Postcard/figure-electronics/motherboard/kicad/Nomenclature-Mere_Figure-V2.xls

Sheet: Mere_Figure
 |  | Reference | Value | Footprint | Datasheet | Tension | ESR | Courant | Puissance | Tolerance | Fabricant | REF Fab | Distributeur | Ref Distri | Description
 |  |  |  |  |  | V | mOhms | A | W | %
Batterie
 | BT500 | BT501 | 3V-Lit | 20mm | http://www.farnell.com/datasheets/2082377.pdf | 3.3 |  |  |  |  | Panasonic | VL-2020/HFN | FARNELL | 8806551 (http://fr.farnell.com/panasonic-electronic-components/vl-2020-hfn/pile-rech-lithium-2020/dp/8806551) | Batterie rechargeable, Lithium-pentoxyde de vanadium, 20 mAh, 3 V, 2020, Broches CI, 20 mm
Condensateurs |  |  |  |  |  |  | 2
 | C200 | C201 | 22u | 2220 |  | 25 | 3 |  |  | 10 | KEMET | C2220X226K3RACAUTO | FARNELL | 2478282 (http://fr.farnell.com/kemet/c2220x226k3racauto/condensateur-mlcc-x7r-22uf-25v/dp/2478282) | Condensateur céramique multicouche CMS, 2220, 22 µF, 25 V, ± 10%, X7R
 |  | C202 | 22uF | 1206 |  | 16 |  |  |  | 20 | AVX | 1206YD226MAT2A | FARNELL | 1833823 (http://fr.farnell.com/avx/1206yd226mat2a/condensateur-mlcc-x5r-22uf-16v/dp/1833823) | Condensateur céramique multicouche CMS, 1206, 22 µF, 16 V, ± 20%, X5R
 |  | C203 | 15F | C pas 5,5 | http://www.farnell.com/datasheets/2259333.pdf | 2.7 | 35 |  |  |  | AVX | SCCT30B156SRB | FARNELL | 2696615 (http://fr.farnell.com/axiohm/scct30b156srb/super-condensateur-15f-2-7v-radial/dp/2696615) | Supercondensateur, 15 F, 2.7 V, SCC Series, +30%, -10%, À sorties radiales
 |  | C204 | 15F | C pas 5,5 | http://www.farnell.com/datasheets/2259333.pdf | 2.7 | 35 |  |  |  | AVX | SCCT30B156SRB | FARNELL | 2696615 (http://fr.farnell.com/axiohm/scct30b156srb/super-condensateur-15f-2-7v-radial/dp/2696615) | Supercondensateur, 15 F, 2.7 V, SCC Series, +30%, -10%, À sorties radiales
 |  | C205 | 15F | C pas 5,5 | http://www.farnell.com/datasheets/2259333.pdf | 2.7 | 35 |  |  |  | AVX | SCCT30B156SRB | FARNELL | 2696615 (http://fr.farnell.com/axiohm/scct30b156srb/super-condensateur-15f-2-7v-radial/dp/2696615) | Supercondensateur, 15 F, 2.7 V, SCC Series, +30%, -10%, À sorties radiales
 |  | C206 | 15F | C pas 5,5 | http://www.farnell.com/datasheets/2259333.pdf | 2.7 | 35 |  |  |  | AVX | SCCT30B156SRB | FARNELL | 2696615 (http://fr.farnell.com/axiohm/scct30b156srb/super-condensateur-15f-2-7v-radial/dp/2696615) | Supercondensateur, 15 F, 2.7 V, SCC Series, +30%, -10%, À sorties radiales
 |  | C207 | 22uF | 2220 |  | 25 | 3 |  |  | 10 | KEMET | C2220X226K3RACAUTO | FARNELL | 2478282 (http://fr.farnell.com/kemet/c2220x226k3racauto/condensateur-mlcc-x7r-22uf-25v/dp/2478282) | Condensateur céramique multicouche CMS, 2220, 22 µF, 25 V, ± 10%, X7R
 |  | C208 | 680p | 0603 |  | 100 |  |  |  |  | Multicomp | MC0603B681K101CT | FARNELL | 1759134 (http://fr.farnell.com/multicomp/mc0603b681k101ct/condensateur-mlcc-x7r-680pf-100v/dp/1759134) | Condensateur céramique multicouche CMS, 0603, 680 pF, 100 V, ± 10%, X7R, Série MC
 |  | C209 | 6p | 0603 |  | 25 |  |  |  |  | Multicomp | MC0603N6R0D500CT | FARNELL | 1759047 (http://fr.farnell.com/multicomp/mc0603n6r0d500ct/condensateur-mlcc-c0g-np0-6pf/dp/1759047) | Condensateur céramique multicouche CMS, 0603, 6 pF, 50 V, ± 0.5pF, C0G / NP0
 |  | C210 | 47uF | 1206 |  | 10 | 3 |  |  |  | KEMET | C1206C476M8PACTU | FARNELL | 1572639 (http://fr.farnell.com/kemet/c1206c476m8pactu/condensateur-mlcc-x5r-47uf-10v/dp/1572639) | Condensateur céramique multicouche CMS, 1206, 47 µF, 10 V, ± 20%, X5R, Série C
 |  | C211 | 10uF | 1206 |  | 16 |  |  |  | 10 | KEMET | C1206X106K4RACTU | FARNELL | 2575964 (http://fr.farnell.com/kemet/c1206x106k4ractu/condensateur-mlcc-x7r-10uf-16v/dp/2575964) | Condensateur céramique multicouche CMS, 1206 [3216 Metric], 10 µF, 16 V, ± 10%, X7R
 | C300 | C301 | 22u | 2220 |  | 25 | 3 |  |  | 10 | KEMET | C2220X226K3RACAUTO | FARNELL | 2478282 (http://fr.farnell.com/kemet/c2220x226k3racauto/condensateur-mlcc-x7r-22uf-25v/dp/2478282) | Condensateur céramique multicouche CMS, 2220, 22 µF, 25 V, ± 10%, X7R
 |  | C302 | 4u7 | 1210 |  | 25 |  |  |  | 10 | KEMET | C1210F475K3RACTU | FARNELL | 1358508 (http://fr.farnell.com/kemet/c1210f475k3ractu/condensateur-mlcc-x7r-4-7uf-25v/dp/1358508) | Condensateur céramique multicouche CMS, FO-CAP, 1210, 4.7 µF, 25 V, ± 10%, X7R
 |  | C303 | 43p | 0603 |  | 50 |  |  |  | 5 | KEMET | C0603C430J5GACTU | FARNELL | 1865479 (http://fr.farnell.com/kemet/c0603c430j5gactu/condensateur-mlcc-c0g-np0-43pf/dp/1865479) | Condensateur céramique multicouche CMS, 0603, 43 pF, 50 V, ± 5%, C0G / NP0, Série C
 |  | C304 | 9n1 | 0603 |  | 50 |  |  |  | 5 | KEMET | C0603X912J5JACTU | FARNELL | 2579122 (http://fr.farnell.com/kemet/c0603x912j5jactu/condo-mlcc-u2j-9100pf-50v-0603/dp/2579122) | Condensateur céramique multicouche CMS, 0603, 9100 pF, 50 V, ± 5%, U2J
 |  | C305 | 100n | 0603 |  | 25 |  |  |  | 10 | Multicomp | MC0603B104K250CT | FARNELL | 1759037 (http://fr.farnell.com/multicomp/mc0603b104k250ct/condensateur-mlcc-x7r-100nf-25v/dp/1759037) | Condensateur céramique multicouche CMS, 0603, 0.1 µF, 25 V, ± 10%, X7R, Série MC
 |  | C306 | 51p | 0603 |  | 50 |  |  |  | 5 | KEMET | C0603C510J5GACTU | FARNELL | 1865480 (http://fr.farnell.com/kemet/c0603c510j5gactu/condensateur-mlcc-c0g-np0-51pf/dp/1865480) | Condensateur céramique multicouche CMS, 0603, 51 pF, 50 V, ± 5%, C0G / NP0, Série C
 |  | C307 | 2n7 | 0603 |  | 50 |  |  |  | 10 | Multicomp | MC0603B272K500CT | FARNELL | 1759094 (http://fr.farnell.com/multicomp/mc0603b272k500ct/condensateur-mlcc-x7r-2-7nf-50v/dp/1759094) | Condensateur céramique multicouche CMS, 0603, 2700 pF, 50 V, ± 10%, X7R, Série MC
 |  | C308 | 22p | 0603 |  | 50 |  |  |  | 10 | Multicomp | MCU0603C220JCT | FARNELL | 9406107 (http://fr.farnell.com/multicomp/mcu0603c220jct/condensateur-mlcc-c0g-np0-22pf/dp/9406107) | Condensateur céramique multicouche CMS, 0603, 22 pF, 50 V, ± 5%, C0G / NP0, Série MCU
 |  | C309 | 22u | 1206 |  | 16 |  |  |  | 20 | AVX | 1206YD226MAT2A | FARNELL | 1833823 (http://fr.farnell.com/avx/1206yd226mat2a/condensateur-mlcc-x5r-22uf-16v/dp/1833823) | Condensateur céramique multicouche CMS, 1206, 22 µF, 16 V, ± 20%, X5R
 | C400 | C401 | 22u | 2220 |  | 25 | 3 |  |  | 10 | KEMET | C2220X226K3RACAUTO | FARNELL | 2478282 (http://fr.farnell.com/kemet/c2220x226k3racauto/condensateur-mlcc-x7r-22uf-25v/dp/2478282) | Condensateur céramique multicouche CMS, 2220, 22 µF, 25 V, ± 10%, X7R
 |  | C402 | 100n | 0603 |  | 25 |  |  |  | 10 | Multicomp | MC0603B104K250CT | FARNELL | 1759037 (http://fr.farnell.com/multicomp/mc0603b104k250ct/condensateur-mlcc-x7r-100nf-25v/dp/1759037) | Condensateur céramique multicouche CMS, 0603, 0.1 µF, 25 V, ± 10%, X7R, Série MC
 |  | C403 | 1n5 | 0603 |  | 50 |  |  |  | 10 | Multicomp | MC0603B152K500CT | FARNELL | 1759091 (http://fr.farnell.com/multicomp/mc0603b152k500ct/condensateur-mlcc-x7r-1-5nf-50v/dp/1759091) | Condensateur céramique multicouche CMS, 0603, 1500 pF, 50 V, ± 10%, X7R, Série MC
 |  | C404 | 27n | 0603 |  | 50 |  |  |  | 10 | Multicomp | MC0603B273K500CT | FARNELL | 1759111 (http://fr.farnell.com/multicomp/mc0603b273k500ct/condensateur-mlcc-x7r-27nf-50v/dp/1759111) | Condensateur céramique multicouche CMS, 0603 [1608 Metric], 0.027 µF, 50 V, ± 10%, X7R, Série MC
 |  | C405 | 10n | 0603 |  | 50 |  |  |  | 10 | Multicomp | MC0603B103K500CT | FARNELL | 1759102 (http://fr.farnell.com/multicomp/mc0603b103k500ct/condensateur-mlcc-x7r-10nf-50v/dp/1759102) | Condensateur céramique multicouche CMS, 0603, 0.01 µF, 50 V, ± 10%, X7R, Série MC
 |  | C406 | 82u | E12 |  | 35 | 20 |  |  | 10 | Panasonic | 35SVPF82M | FARNELL | 2354811 (http://fr.farnell.com/panasonic-electronic-components/35svpf82m/condensateur-elec-alu-82uf-35v/dp/2354811) | CONDENSATEUR ELEC ALU 82UF 35V CMS
 |  | C407 | 82u | E12 |  | 35 | 20 |  |  | 10 | Panasonic | 35SVPF82M | FARNELL | 2354811 (http://fr.farnell.com/panasonic-electronic-components/35svpf82m/condensateur-elec-alu-82uf-35v/dp/2354811) | CONDENSATEUR ELEC ALU 82UF 35V CMS
 |  | C408 | 100n | 0603 |  | 25 |  |  |  | 10 | Multicomp | MC0603B104K250CT | FARNELL | 1759037 (http://fr.farnell.com/multicomp/mc0603b104k250ct/condensateur-mlcc-x7r-100nf-25v/dp/1759037) | Condensateur céramique multicouche CMS, 0603, 0.1 µF, 25 V, ± 10%, X7R, Série MC
 | C500 | C501 | 1u | 0603 |  | 10 |  |  |  | 10 | Multicomp | MC0603X105K100CT | FARNELL | 1759399 (http://fr.farnell.com/multicomp/mc0603x105k100ct/condensateur-mlcc-x5r-1uf-10v/dp/1759399) | Condensateur céramique multicouche CMS, 0603, 1 µF, 10 V, ± 10%, X5R, Série MC
 |  | C502 | 6p | 0603 |  | 50 |  |  |  | 10 | Multicomp | MC0603N6R0D500CT | FARNELL | 1759047 (http://fr.farnell.com/multicomp/mc0603n6r0d500ct/condensateur-mlcc-c0g-np0-6pf/dp/1759047) | Condensateur céramique multicouche CMS, 0603, 6 pF, 50 V, ± 0.5pF, C0G / NP0
 |  | C503 | 6p | 0603 |  | 50 |  |  |  | 10 | Multicomp | MC0603N6R0D500CT | FARNELL | 1759047 (http://fr.farnell.com/multicomp/mc0603n6r0d500ct/condensateur-mlcc-c0g-np0-6pf/dp/1759047) | Condensateur céramique multicouche CMS, 0603, 6 pF, 50 V, ± 0.5pF, C0G / NP0
 |  | C504 | 1u | 0603 |  | 10 |  |  |  | 10 | Multicomp | MC0603X105K100CT | FARNELL | 1759399 (http://fr.farnell.com/multicomp/mc0603x105k100ct/condensateur-mlcc-x5r-1uf-10v/dp/1759399) | Condensateur céramique multicouche CMS, 0603, 1 µF, 10 V, ± 10%, X5R, Série MC
 | C600 | C601 | 22u | 2220 |  | 25 | 3 |  |  | 10 | KEMET | C2220X226K3RACAUTO | FARNELL | 2478282 (http://fr.farnell.com/kemet/c2220x226k3racauto/condensateur-mlcc-x7r-22uf-25v/dp/2478282) | Condensateur céramique multicouche CMS, 2220, 22 µF, 25 V, ± 10%, X7R
 |  | C602 | 4u7 | 1210 |  | 25 |  |  |  | 10 | KEMET | C1210F475K3RACTU | FARNELL | 1358508 (http://fr.farnell.com/kemet/c1210f475k3ractu/condensateur-mlcc-x7r-4-7uf-25v/dp/1358508) | Condensateur céramique multicouche CMS, FO-CAP, 1210, 4.7 µF, 25 V, ± 10%, X7R
 |  | C603 | 43p | 0603 |  | 50 |  |  |  | 5 | KEMET | C0603C430J5GACTU | FARNELL | 1865479 (http://fr.farnell.com/kemet/c0603c430j5gactu/condensateur-mlcc-c0g-np0-43pf/dp/1865479) | Condensateur céramique multicouche CMS, 0603, 43 pF, 50 V, ± 5%, C0G / NP0, Série C
 |  | C604 | 56n | 0603 |  | 16 |  |  |  | 10 | Multicomp | MC0603B563K160CT | FARNELL | 1759013 (http://fr.farnell.com/multicomp/mc0603b563k160ct/condensateur-mlcc-x7r-56nf-16v/dp/1759013) | Condensateur céramique multicouche CMS, 0603, 0.056 µF, 16 V, ± 10%, X7R, Série MC
 |  | C605 | 100n | 0603 |  | 25 |  |  |  | 10 | Multicomp | MC0603B104K250CT | FARNELL | 1759037 (http://fr.farnell.com/multicomp/mc0603b104k250ct/condensateur-mlcc-x7r-100nf-25v/dp/1759037) | Condensateur céramique multicouche CMS, 0603, 0.1 µF, 25 V, ± 10%, X7R, Série MC
 |  | C606 | 110p | 0402 |  | 50 |  |  |  | 5 | Multicomp | MC0402N111J500CT | FARNELL | 1758970 (http://fr.farnell.com/multicomp/mc0402n111j500ct/condensateur-mlcc-c0g-np0-110pf/dp/1758970) | Condensateur céramique multicouche CMS, 0402, 110 pF, 50 V, ± 5%, C0G / NP0, Série MC
 |  | C607 | 2n7 | 0603 |  | 50 |  |  |  | 10 | Multicomp | MC0603B272K500CT | FARNELL | 1759094 (http://fr.farnell.com/multicomp/mc0603b272k500ct/condensateur-mlcc-x7r-2-7nf-50v/dp/1759094) | Condensateur céramique multicouche CMS, 0603, 2700 pF, 50 V, ± 10%, X7R, Série MC
 |  | C608 | 22p | 0603 |  | 50 |  |  |  | 10 | Multicomp | MCU0603C220JCT | FARNELL | 9406107 (http://fr.farnell.com/multicomp/mcu0603c220jct/condensateur-mlcc-c0g-np0-22pf/dp/9406107) | Condensateur céramique multicouche CMS, 0603, 22 pF, 50 V, ± 5%, C0G / NP0, Série MCU
 |  | C609 | 22u | 1206 |  | 16 |  |  |  | 20 | AVX | 1206YD226MAT2A | FARNELL | 1833823 (http://fr.farnell.com/avx/1206yd226mat2a/condensateur-mlcc-x5r-22uf-16v/dp/1833823) | Condensateur céramique multicouche CMS, 1206, 22 µF, 16 V, ± 20%, X5R
 | C700 | C701 | 10u | 1206 |  | 25 |  |  |  | 10 | Multicomp | MC1206X106K250CT | FARNELL | 2320887 (http://fr.farnell.com/multicomp/mc1206x106k250ct/condensateur-mlcc-x5r-10uf-25v/dp/2320887) | Condensateur céramique multicouche CMS, 1206 , 10 µF, 25 V, ± 10%, X5R, Série MC
 |  | C702 | 10u | 1206 |  | 25 |  |  |  | 10 | Multicomp | MC1206X106K250CT | FARNELL | 2320887 (http://fr.farnell.com/multicomp/mc1206x106k250ct/condensateur-mlcc-x5r-10uf-25v/dp/2320887) | Condensateur céramique multicouche CMS, 1206 , 10 µF, 25 V, ± 10%, X5R, Série MC
 | C800 | C801 | 33n | 15mm |  | 310 |  |  | X2-300 | 10 | Wurth | 890334025006CS | FARNELL | 2449960 (http://fr.farnell.com/wurth-elektronik/890334025006cs/condensateur-film-pp-0-033uf-310vac/dp/2449960) | Condensateur film, 0.033 µF, 310 V, Polypropylène (PP), ± 10%, Série WCAP-FTXX
 |  | C802 | 100n | 22,5mm |  | 300 |  |  |  | 20 | KEMET | R413N310040M1M | FARNELL | 2495804 (http://fr.farnell.com/kemet/r413n310040m1m/condens-sup-y2-pp-0-1uf-300vac/dp/2495804) | Condensateur film, 0.1 µF, Y2, 300 V, ± 20%, Série R41, À sorties radiales
 |  | C803 | 10u | 1206 |  | 16 |  |  |  | 10 | KEMET | C1206X106K4RACTU | FARNELL | 2575964 (http://fr.farnell.com/kemet/c1206x106k4ractu/condensateur-mlcc-x7r-10uf-16v/dp/2575964) | Condensateur céramique multicouche CMS, 1206 [3216 Metric], 10 µF, 16 V, ± 10%, X7R
Diodes
 | D100 | D101 | SBR2A40 | PowerDI123 | http://www.farnell.com/datasheets/2096657.pdf | 40 |  | 2 |  |  | Diodes Inc | SBR2A40P1-7 | FARNELL | 1713961 (http://fr.farnell.com/diodes-inc/sbr2a40p1-7/redresseur-super-b-powerdi-123/dp/1713961) | Diode de récupération standard, POWERDI®, 40 V, 2 A, Une, 500 mV, 50 A
 | D200 | D201 | SBR2A40 | PowerDI123 | http://www.farnell.com/datasheets/2096657.pdf | 40 |  | 2 |  |  | Diodes Inc | SBR2A40P1-7 | FARNELL | 1713961 (http://fr.farnell.com/diodes-inc/sbr2a40p1-7/redresseur-super-b-powerdi-123/dp/1713961) | Diode de récupération standard, POWERDI®, 40 V, 2 A, Une, 500 mV, 50 A
 |  | D202 | SBR2A40 | PowerDI123 | http://www.farnell.com/datasheets/2096657.pdf | 40 |  | 2 |  |  | Diodes Inc | SBR2A40P1-7 | FARNELL | 1713961 (http://fr.farnell.com/diodes-inc/sbr2a40p1-7/redresseur-super-b-powerdi-123/dp/1713961) | Diode de récupération standard, POWERDI®, 40 V, 2 A, Une, 500 mV, 50 A
 |  | D203 | SBR2A40 | PowerDI123 | http://www.farnell.com/datasheets/2096657.pdf | 40 |  | 2 |  |  | Diodes Inc | SBR2A40P1-7 | FARNELL | 1713961 (http://fr.farnell.com/diodes-inc/sbr2a40p1-7/redresseur-super-b-powerdi-123/dp/1713961) | Diode de récupération standard, POWERDI®, 40 V, 2 A, Une, 500 mV, 50 A
 |  | D204 | SBR2A40 | PowerDI123 | http://www.farnell.com/datasheets/2096657.pdf | 40 |  | 2 |  |  | Diodes Inc | SBR2A40P1-7 | FARNELL | 1713961 (http://fr.farnell.com/diodes-inc/sbr2a40p1-7/redresseur-super-b-powerdi-123/dp/1713961) | Diode de récupération standard, POWERDI®, 40 V, 2 A, Une, 500 mV, 50 A
 | D400 | D401 | MBRD835LT4G | TO-252 | http://www.farnell.com/datasheets/33914.pdf | 35 |  | 8 |  |  | ON Semi | MBRD835LT4G | FARNELL | 1611349 (http://fr.farnell.com/on-semiconductor/mbrd835lt4g/diode-schottky/dp/1611349) | Redresseur Schottky, 35 V, 8 A, Une, TO-252, 3 Broche(s), 510 mV
 | D500 | D501 | Zener-3V3 | SOD-323FL | http://www.farnell.com/datasheets/2021487.pdf | 3.3 |  |  |  |  | Rohm | UDZVFHTE-173.3B | FARNELL | 2528863 (http://fr.farnell.com/rohm/udzvfhte-173-3b/diode-zener-3-3v-sod-323fl/dp/2528863) | Diode simple Zener, AEC-Q101, 3.3 V, 200 mW, SOD-323FL, 2 Broche(s), 150 °C
 | D700 | D701 | SBR2A40 | PowerDI123 | http://www.farnell.com/datasheets/2096657.pdf | 40 |  | 2 |  |  | Diodes Inc | SBR2A40P1-7 | FARNELL | 1713961 (http://fr.farnell.com/diodes-inc/sbr2a40p1-7/redresseur-super-b-powerdi-123/dp/1713961) | Diode de récupération standard, POWERDI®, 40 V, 2 A, Une, 500 mV, 50 A
 |  | D702 | SBR2A40 | PowerDI123 | http://www.farnell.com/datasheets/2096657.pdf | 40 |  | 2 |  |  | Diodes Inc | SBR2A40P1-7 | FARNELL | 1713961 (http://fr.farnell.com/diodes-inc/sbr2a40p1-7/redresseur-super-b-powerdi-123/dp/1713961) | Diode de récupération standard, POWERDI®, 40 V, 2 A, Une, 500 mV, 50 A
 | D800 | D801 | 1N4001 | DO41 | http://www.farnell.com/datasheets/639187.pdf |  |  |  |  |  | Diodes Inc | 1N4001-T | FARNELL | 1843694 (http://fr.farnell.com/diodes-inc/1n4001-t/diode-de-redressement-50v1ado/dp/1843694) | Diode de récupération standard, 50 V, 1 A, Une, 1 V, 30 A
Inductances
 | L300 | L301 | 3u3 | WE-HCI | http://www.farnell.com/datasheets/1735740.pdf |  | 17.2 | 6.5 |  |  | WURTH | 744311330 | FARNELL | 1636193 (http://fr.farnell.com/wurth-elektronik/744311330/inductance-fort-courant-2/dp/1636193) | Inductance de puissance CMS, Série WE-HCI, 3.3 µH, 6.5 A, 11 A, Blindé, 0.0172 ohm
 | L400 | L401 | 10u | WE-HCC | http://www.farnell.com/datasheets/654696.pdf |  | 14.4 | 9 |  |  | WURTH | 744332100 | FARNELL | 1848238 (http://fr.farnell.com/wurth-elektronik/7443321000/inductor-10uh-9a-20/dp/1848238) | Inductance de puissance CMS, Série WE-HCC, 10 µH, 9 A, 10 A, Blindé, 0.0144 ohm
 | L600 | L601 | 10u | VLP | http://www.farnell.com/datasheets/2124514.pdf |  | 40 | 3.5 |  |  | TDK | VLP8040T-100M | FARNELL | 2345211 (http://fr.farnell.com/tdk/vlp8040t-100m/inductance-puissance-10uh-3-2a/dp/2345211) | Inductance de puissance CMS, Série VLP, 10 µH, 3.5 A, 3.2 A, Blindé, 0.038 ohm
Connecteurs
 | P100 | P101 | Master-12V | 5mm | http://docs-europe.electrocomponents.com/webdocs/14fb/0900766b814fb452.pdf | 12 |  | 16 |  |  | WURTH | 691386700002 | RS | 122-4903 (http://fr.rs-online.com/web/p/borniers-pour-ci/1224903/?searchTerm=122-4903) | Bloc de jonction enfichable Embase CI, Wurth Elektronik, série 3867, pas 5mm, 2 Contacts, A souder
 |  | P102 | detection-230V | 7,62mm | http://docs-europe.electrocomponents.com/webdocs/133a/0900766b8133a1eb.pdf | 230 |  | 20 |  |  | WURTH | 691313410003 | RS | 826-7481 (http://fr.rs-online.com/web/p/borniers-pour-ci/8267481/?searchTerm=826-7481) | Bloc de jonction enfichable Embase CI, Wurth Elektronik, série 3134, pas 7.62mm, 3 Contacts, Angle droit
 |  | P103 | Secteur | 7,62mm | http://docs-europe.electrocomponents.com/webdocs/133a/0900766b8133a1eb.pdf | 230 |  | 20 |  |  | WURTH | 691313410003 | RS | 826-7481 (http://fr.rs-online.com/web/p/borniers-pour-ci/8267481/?searchTerm=826-7481) | Bloc de jonction enfichable Embase CI, Wurth Elektronik, série 3134, pas 7.62mm, 3 Contacts, Angle droit
 |  | P104 | Secteur | 7,62mm | http://docs-europe.electrocomponents.com/webdocs/133a/0900766b8133a1eb.pdf | 230 |  | 20 |  |  | WURTH | 691313410003 | RS | 826-7481 (http://fr.rs-online.com/web/p/borniers-pour-ci/8267481/?searchTerm=826-7481) | Bloc de jonction enfichable Embase CI, Wurth Elektronik, série 3134, pas 7.62mm, 3 Contacts, Angle droit
 |  | P105 | 2Pts-CANON 1200D | 3,81mm | http://docs-europe.electrocomponents.com/webdocs/133a/0900766b8133a1f8.pdf | 7.4 |  | 10.5 |  |  | WURTH | 691322310004 | RS | 824-6655 (http://fr.rs-online.com/web/p/borniers-pour-ci/8246655/?searchTerm=824-6655) | Bloc de jonction enfichable Embase CI, Wurth Elektronik, série 322, pas 3.81mm, 4 Contacts, Droit, montage Traversant
 |  | P106 | 2Pts-Flash | 3,81mm | http://docs-europe.electrocomponents.com/webdocs/133a/0900766b8133a1f8.pdf | 6.5 |  | 10.5 |  |  | WURTH | 691322310002 | RS | 824-6658 (http://fr.rs-online.com/web/p/borniers-pour-ci/8246658/?searchTerm=824-6658) | Bloc de jonction enfichable Embase CI, Wurth Elektronik, série 322, pas 3.81mm, 2 Contacts, Droit, montage Traversant
 |  | P107 | 2Pts-shutter |  |  |  |  |  |  |  |  | voir P105
 |  | P108 | Bouton Poussoir | 2,5mm | http://docs-europe.electrocomponents.com/webdocs/14fb/0900766b814fb43a.pdf | 5 |  | 12 |  |  | WURTH | 691382010002 | RS | 122-4921 (http://fr.rs-online.com/web/p/borniers-pour-ci/1224921/?searchTerm=122-4921) | Bloc de jonction enfichable Embase CI, Wurth Elektronik, série 382, pas 2.5mm, 2 Contacts, Horizontal, A souder
 |  | P109 | HT910-E | 6P6C | http://docs-europe.electrocomponents.com/webdocs/1388/0900766b81388626.pdf | 12 |  | 1 |  |  | MOLEX | 95522-2667 | RS | 848-6705 (http://fr.rs-online.com/web/p/connecteurs-rj11/8486705/?searchTerm=848-6705) | Embase Modulaire, Femelle, 6P6C, Non blindé, Droit, Traversant,
 |  | P110 | GACHE | 3,5mm | http://docs-europe.electrocomponents.com/webdocs/133a/0900766b8133a1f7.pdf | 12 |  | 10.5 |  |  | WURTH | 691322110002 | RS | 824-6636 (http://fr.rs-online.com/web/p/borniers-pour-ci/8246636/?searchTerm=824-6636) | Bloc de jonction enfichable Embase CI, Wurth Elektronik, série 3221, pas 3.5mm, 2 Contacts, Droit, montage Traversant
 |  | P111 | 24V-PRINT | 3,5mm | http://docs-europe.electrocomponents.com/webdocs/133a/0900766b8133a1f7.pdf | 24 |  | 10.5 |  |  | WURTH | 691322110002 | RS | 824-6636 (http://fr.rs-online.com/web/p/borniers-pour-ci/8246636/?searchTerm=824-6636) | Bloc de jonction enfichable Embase CI, Wurth Elektronik, série 3221, pas 3.5mm, 2 Contacts, Droit, montage Traversant
 | P500 | P501 | alim | 5mm | http://docs-europe.electrocomponents.com/webdocs/133a/0900766b8133a1d7.pdf | 5 |  |  |  |  | WURTH | 691101710002 | RS | 826-7214 (http://fr.rs-online.com/web/p/borniers-pour-ci/8267214/?searchTerm=826-7214) | Bornier pour CI Bloc de jonction PCB, Wurth Elektronik, série 101, pas 5mm, 2 Contacts, Droit, montage Traversant
Transistors
 | Q100 | Q101 | Q_NMOS_GSD | TO-252 | http://www.farnell.com/datasheets/2050341.pdf | 100 | 0.162 | 8.8 |  |  | VISHAY | SUD09P10-195-GE3 | FARNELL | 1859014 (http://fr.farnell.com/vishay/sud09p10-195-ge3/mosfet-canal-p-diode-100v-8-8a/dp/1859014) | Transistor MOSFET, Canal P, -8.8 A, -100 V, 0.162 ohm, -10 V, -1 V
 | Q300 | Q301 | Q_NMOS_GSD | SOT-23 | http://www.farnell.com/datasheets/2246751.pdf | 100 | 1200 | 0.17 |  |  | Fairchild | BSS123 | FARNELL | 2251951 (http://fr.farnell.com/fairchild-semiconductor/bss123/mosfet-n-ch-100v-170ma-sot-23/dp/2251951) | Transistor MOSFET, Canal N, 170 mA, 100 V, 1.2 ohm, 10 V, 1.7 V
 | Q400 | Q401 | CSD17304Q3 | Q3 Pack | http://www.ti.com/lit/ds/symlink/csd17304q3.pdf | 30 | 6 | 56 |  |  | Texas | CSD17304Q3 | FARNELL | 2501089 (http://fr.farnell.com/texas-instruments/csd17304q3/mosfet-canal-n-30v-56a-vson-8/dp/2501089) | Transistor MOSFET, Canal N, 56 A, 30 V, 0.0059 ohm, 8 V, 1.3 V
 | Q500 | Q501 | Q_NMOS_GSD | SOT-23 | http://www.farnell.com/datasheets/2246751.pdf | 100 | 1200 | 0.17 |  |  | Fairchild | BSS123 | FARNELL | 2251951 (http://fr.farnell.com/fairchild-semiconductor/bss123/mosfet-n-ch-100v-170ma-sot-23/dp/2251951) | Transistor MOSFET, Canal N, 170 mA, 100 V, 1.2 ohm, 10 V, 1.7 V
 | Q700 | Q701 | Q_NMOS_GSD | SOT-23 | http://www.farnell.com/datasheets/2246751.pdf | 100 | 1200 | 0.17 |  |  | Fairchild | BSS123 | FARNELL | 2251951 (http://fr.farnell.com/fairchild-semiconductor/bss123/mosfet-n-ch-100v-170ma-sot-23/dp/2251951) | Transistor MOSFET, Canal N, 170 mA, 100 V, 1.2 ohm, 10 V, 1.7 V
 |  | Q702 | Q_NMOS_GSD | SOT-23 | http://www.farnell.com/datasheets/2246751.pdf | 100 | 1200 | 0.17 |  |  | Fairchild | BSS123 | FARNELL | 2251951 (http://fr.farnell.com/fairchild-semiconductor/bss123/mosfet-n-ch-100v-170ma-sot-23/dp/2251951) | Transistor MOSFET, Canal N, 170 mA, 100 V, 1.2 ohm, 10 V, 1.7 V
Resistances
 | R100 | R101 | 1Meg | 0603 |  | 50 |  |  | 0.1 | 1 | YAGEO | RC0603FR-071ML | FARNELL | 9238840 (http://fr.farnell.com/yageo-phycomp/rc0603fr-071ml/res-couche-epaisse-1m-1-0-1w-0603/dp/9238840) | Résistance à puce CMS, Couche épaisse, 1 Mohm, 50 V, 0603, 100 mW, ± 1%, Série RC
 | R200 | R202 | 0 | 0603 |  | 50 |  |  | 0.1 | 1 | YAGEO | RC0603FR-070RL | FARNELL | 2309106 (http://fr.farnell.com/yageo/rc0603fr-070rl/res-couche-epaisse-0r-1-0-1w-0603/dp/2309106) | Résistance à puce CMS, Couche épaisse, 0 ohm, 50 V,0603, 100 mW, ± 1%, Série RC
 |  | R201 | 0 | 0603 |  | 50 |  |  | 0.1 | 1 | YAGEO | RC0603FR-070RL | FARNELL | 2309106 (http://fr.farnell.com/yageo/rc0603fr-070rl/res-couche-epaisse-0r-1-0-1w-0603/dp/2309106) | Résistance à puce CMS, Couche épaisse, 0 ohm, 50 V, 0603, 100 mW, ± 1%, Série RC
 |  | R203 | 240 | 0603 |  | 75 |  |  | 0.1 | 1 | WALSIN | WR06X2400FTL | FARNELL | 2670708 (http://fr.farnell.com/walsin/wr06x2400ftl/res-couche-epaisse-240r-1-0-1w/dp/2670708) | Résistance à puce CMS, 240 ohm, 75 V, 0603, 100 mW, ± 1%, WR06 Series
 |  | R204 | 1650 | 0603 |  | 75 |  |  | 0.1 | 1 | WALSIN | WR06X1651FTL | FARNELL | 2670655 (http://fr.farnell.com/walsin/wr06x1651ftl/res-couche-epaisse-1k65-1-0-1w/dp/2670655) | Résistance à puce CMS, 1.65 kohm, 75 V, 0603, 100 mW, ± 1%, WR06 Series
 |  | R205 | 10k | 0603 |  | 75 |  |  | 0.1 | 1 | VISHAY | CRCW060310K0JNEA | FARNELL | 2693095 (http://fr.farnell.com/vishay/crcw060310k0jnea/res-aec-q200-10k-5-0-1w-0603/dp/2693095) | Résistance à puce CMS, 10 kohm, 75 V, 0603, 100 mW, ± 5%, CRCW Series
 |  | R206 | 10k | 0603 |  | 75 |  |  | 0.1 | 1 | VISHAY | CRCW060310K0JNEA | FARNELL | 2693095 (http://fr.farnell.com/vishay/crcw060310k0jnea/res-aec-q200-10k-5-0-1w-0603/dp/2693095) | Résistance à puce CMS, 10 kohm, 75 V, 0603, 100 mW, ± 5%, CRCW Series
 |  | R207 | 10k | 0603 |  | 75 |  |  | 0.1 | 1 | VISHAY | CRCW060310K0JNEA | FARNELL | 2693095 (http://fr.farnell.com/vishay/crcw060310k0jnea/res-aec-q200-10k-5-0-1w-0603/dp/2693095) | Résistance à puce CMS, 10 kohm, 75 V, 0603, 100 mW, ± 5%, CRCW Series
 |  | R208 | 10k | 0603 |  | 75 |  |  | 0.1 | 1 | VISHAY | CRCW060310K0JNEA | FARNELL | 2693095 (http://fr.farnell.com/vishay/crcw060310k0jnea/res-aec-q200-10k-5-0-1w-0603/dp/2693095) | Résistance à puce CMS, 10 kohm, 75 V, 0603, 100 mW, ± 5%, CRCW Series
 |  | R209 | 100k | 0603 |  | 50 |  |  | 0.1 | 1 | YAGEO | RC0603FR-07100KL | FARNELL | 9238727 (http://fr.farnell.com/yageo-phycomp/rc0603fr-07100kl/res-couche-epaisse-100k-1-0-1w/dp/9238727) | Résistance à puce CMS, Couche épaisse, 100 kohm, 50 V, 0603, 100 mW, ± 1%, Série RC
 |  | R210 | 523k | 0603 |  | 75 |  |  | 0.1 | 1 | WALSIN | WR06X5233FTL | FARNELL | 2670836 (http://fr.farnell.com/walsin/wr06x5233ftl/res-couche-epaisse-523k-1-0-1w/dp/2670836) | Résistance à puce CMS, 523 kohm, 75 V, 0603, 100 mW, ± 1%, WR06 Series
 |  | R211 | 100k | 0603 |  | 50 |  |  | 0.1 | 1 | YAGEO | RC0603FR-07100KL | FARNELL | 9238727 (http://fr.farnell.com/yageo-phycomp/rc0603fr-07100kl/res-couche-epaisse-100k-1-0-1w/dp/9238727) | Résistance à puce CMS, Couche épaisse, 100 kohm, 50 V, 0603, 100 mW, ± 1%, Série RC
 | R300 | R301 | 0 | 0603 |  | 50 |  |  | 0.1 | 1 | YAGEO | RC0603FR-070RL | FARNELL | 2309106 (http://fr.farnell.com/yageo/rc0603fr-070rl/res-couche-epaisse-0r-1-0-1w-0603/dp/2309106) | Résistance à puce CMS, Couche épaisse, 0 ohm, 50 V, 0603, 100 mW, ± 1%, Série RC
 |  | R302 | 105k | 0603 |  | 75 |  |  | 0.1 | 1 | WALSIN | WR06X1053FTL | FARNELL | 2670599 (http://fr.farnell.com/walsin/wr06x1053ftl/res-couche-epaisse-105k-1-0-1w/dp/2670599) | Résistance à puce CMS, 105 kohm, 75 V, 0603, 100 mW, ± 1%, WR06 Series
 |  | R303 | 37k4 | 0603 |  | 75 |  |  | 0.1 | 1 | WALSIN | WR06X3742FTL | FARNELL | 2670780 (http://fr.farnell.com/walsin/wr06x3742ftl/res-couche-epaisse-37k4-1-0-1w/dp/2670780) | Résistance à puce CMS, 37.4 kohm, 75 V, 0603 [1608 Metric], 100 mW, ± 1%, WR06 Series
 |  | R304 | 53k6 | 0603 |  | 75 |  |  | 0.1 | 1 | Panasonic | ERJ3EKF5362V | FARNELL | 2059475 (http://fr.farnell.com/panasonic-electronic-components/erj3ekf5362v/res-couche-epaisse-53-6k-1-0-1w/dp/2059475) | Résistance à puce CMS, Couche épaisse, 53.6 kohm, 75 V, 0603, 100 mW, ± 1%
 |  | R305 | 1Meg | 0603 |  | 50 |  |  | 0.1 | 1 | YAGEO | RC0603FR-071ML | FARNELL | 9238840 (http://fr.farnell.com/yageo-phycomp/rc0603fr-071ml/res-couche-epaisse-1m-1-0-1w-0603/dp/9238840) | Résistance à puce CMS, Couche épaisse, 1 Mohm, 50 V, 0603, 100 mW, ± 1%, Série RC
 |  | R306 | 3k92 | 0603 |  | 75 |  |  | 0.1 | 1 | WALSIN | WR06X3921FTL | FARNELL | 2670788 (http://fr.farnell.com/walsin/wr06x3921ftl/res-couche-epaisse-3k92-1-0-1w/dp/2670788) | Résistance à puce CMS, 3.92 kohm, 75 V, 0603, 100 mW, ± 1%, WR06 Series
 |  | R307 | 97k6 | 0603 |  | 75 |  |  | 0.1 | 1 | WALSIN | WR06X9762FTL | FARNELL | 2670925 (http://fr.farnell.com/walsin/wr06x9762ftl/res-couche-epaisse-97k6-1-0-1w/dp/2670925) | Résistance à puce CMS, 97.6 kohm, 75 V, 0603 [1608 Metric], 100 mW, ± 1%, WR06 Series
 |  | R308 | 10k | 0603 |  | 75 |  |  | 0.1 | 1 | VISHAY | CRCW060310K0JNEA | FARNELL | 2693095 (http://fr.farnell.com/vishay/crcw060310k0jnea/res-aec-q200-10k-5-0-1w-0603/dp/2693095) | Résistance à puce CMS, 10 kohm, 75 V, 0603, 100 mW, ± 5%, CRCW Series
 | R400 | R401 | 0 | 0603 |  | 50 |  |  | 0.1 | 1 | YAGEO | RC0603FR-070RL | FARNELL | 2309106 (http://fr.farnell.com/yageo/rc0603fr-070rl/res-couche-epaisse-0r-1-0-1w-0603/dp/2309106) | Résistance à puce CMS, Couche épaisse, 0 ohm, 50 V, 0603, 100 mW, ± 1%, Série RC
 |  | R402 | 100 | 0603 |  | 50 |  |  | 0.1 | 1 | Multicomp | MCWR06X1000FTL | FARNELL | 2447227 (http://fr.farnell.com/multicomp/mcwr06x1000ftl/res-couche-epaisse-100r-1-0-1w/dp/2447227) | Résistance à puce CMS, Couche épaisse, 100 ohm, 50 V, 0603, 100 mW, ± 1%, Série MCWR
 |  | R403 | 100 | 0603 |  | 50 |  |  | 0.1 | 1 | Multicomp | MCWR06X1000FTL | FARNELL | 2447227 (http://fr.farnell.com/multicomp/mcwr06x1000ftl/res-couche-epaisse-100r-1-0-1w/dp/2447227) | Résistance à puce CMS, Couche épaisse, 100 ohm, 50 V, 0603, 100 mW, ± 1%, Série MCWR
 |  | R404 | 100 | 0603 |  | 50 |  |  | 0.1 | 1 | Multicomp | MCWR06X1000FTL | FARNELL | 2447227 (http://fr.farnell.com/multicomp/mcwr06x1000ftl/res-couche-epaisse-100r-1-0-1w/dp/2447227) | Résistance à puce CMS, Couche épaisse, 100 ohm, 50 V, 0603, 100 mW, ± 1%, Série MCWR
 |  | R405 | 8mo-1W | 2010 |  | 200 |  |  | 0.5 | 1 | WELWYN | LRF2010-R01FW | FARNELL | 1100044 (http://fr.farnell.com/welwyn/lrf2010-r01fw/res-couche-epaisse-0-01r-1-1w/dp/1100044) | Résistance à puce CMS, Couche épaisse, 0.01 ohm, 200 V, 2010, 1 W, ± 1%, Série LRF
 |  | R406 | 18k2 | 0603 |  | 75 |  |  | 0.1 | 1 | Panasonic | ERJ3EKF1822V | FARNELL | 2059428 (http://fr.farnell.com/panasonic-electronic-components/erj3ekf1822v/res-couche-epaisse-18-2k-1-0-1w/dp/2059428) | Résistance à puce CMS, Couche épaisse, 18.2 kohm, 75 V, 0603, 100 mW, ± 1%
 |  | R407 | 1k | 0603 |  | 50 |  |  | 0.1 | 1 | YAGEO | RC0603FR-071KL. | FARNELL | 9238484 (http://fr.farnell.com/yageo-phycomp/rc0603fr-071kl/res-couche-epaisse-1k-1-0-1w-0603/dp/9238484) | Résistance à puce CMS, Couche épaisse, 1 kohm, 50 V, 0603, 100 mW, ± 1%, Série RC
 | R500 | R501 | 47k | 0603 |  | 75 |  |  | 0.1 | 1 | Multicomp | MCMR06X4702FTL | FARNELL | 2073510 (http://fr.farnell.com/multicomp/mcmr06x4702ftl/res-ceramique-47k-1-0-1w-0603/dp/2073510) | Résistance à puce CMS, Céramique, 47 kohm, 75 V, 0603 [1608 Metric], 100 mW, ± 1%, Série MCMR
 |  | R502 | 300 | 0603 |  | 75 |  |  | 0.1 | 1 | WALSIN | WR06X3000FTL | FARNELL | 2502445 (http://fr.farnell.com/walsin/wr06x3000ftl/res-couche-epaisse-300r-1-75v/dp/2502445) | Résistance à puce CMS, 300 ohm, 75 V, 0603 [1608 Metric], 100 mW, ± 1%, WR06 Series
 |  | R503 | 1Meg | 0603 |  | 50 |  |  | 0.1 | 1 | YAGEO | RC0603FR-071ML | FARNELL | 9238840 (http://fr.farnell.com/yageo-phycomp/rc0603fr-071ml/res-couche-epaisse-1m-1-0-1w-0603/dp/9238840) | Résistance à puce CMS, Couche épaisse, 1 Mohm, 50 V, 0603, 100 mW, ± 1%, Série RC
 |  | R504 | 100k | 0603 |  | 50 |  |  | 0.1 | 1 | YAGEO | RC0603FR-07100KL | FARNELL | 9238727 (http://fr.farnell.com/yageo-phycomp/rc0603fr-07100kl/res-couche-epaisse-100k-1-0-1w/dp/9238727) | Résistance à puce CMS, Couche épaisse, 100 kohm, 50 V, 0603, 100 mW, ± 1%, Série RC
 |  | R505 | 100k | 0603 |  | 50 |  |  | 0.1 | 1 | YAGEO | RC0603FR-07100KL | FARNELL | 9238727 (http://fr.farnell.com/yageo-phycomp/rc0603fr-07100kl/res-couche-epaisse-100k-1-0-1w/dp/9238727) | Résistance à puce CMS, Couche épaisse, 100 kohm, 50 V, 0603, 100 mW, ± 1%, Série RC
 |  | R506 | 100k | 0603 |  | 50 |  |  | 0.1 | 1 | YAGEO | RC0603FR-07100KL | FARNELL | 9238727 (http://fr.farnell.com/yageo-phycomp/rc0603fr-07100kl/res-couche-epaisse-100k-1-0-1w/dp/9238727) | Résistance à puce CMS, Couche épaisse, 100 kohm, 50 V, 0603, 100 mW, ± 1%, Série RC
 | R600 | R601 | 0 | 0603 |  | 50 |  |  | 0.1 | 1 | YAGEO | RC0603FR-070RL | FARNELL | 2309106 (http://fr.farnell.com/yageo/rc0603fr-070rl/res-couche-epaisse-0r-1-0-1w-0603/dp/2309106) | Résistance à puce CMS, Couche épaisse, 0 ohm, 50 V, 0603 , 100 mW, ± 1%, Série RC
 |  | R602 | 105k | 0603 |  | 75 |  |  | 0.1 | 1 | WALSIN | WR06X1053FTL | FARNELL | 2670599 (http://fr.farnell.com/walsin/wr06x1053ftl/res-couche-epaisse-105k-1-0-1w/dp/2670599) | Résistance à puce CMS, 105 kohm, 75 V, 0603, 100 mW, ± 1%, WR06 Series
 |  | R603 | 37k4 | 0603 |  | 75 |  |  | 0.1 | 1 | WALSIN | WR06X3742FTL | FARNELL | 2670780 (http://fr.farnell.com/walsin/wr06x3742ftl/res-couche-epaisse-37k4-1-0-1w/dp/2670780) | Résistance à puce CMS, 37.4 kohm, 75 V, 0603, 100 mW, ± 1%, WR06 Series
 |  | R604 | 53k6 | 0603 |  | 75 |  |  | 0.1 | 1 | Panasonic | ERJ3EKF5362V | FARNELL | 2059475 (http://fr.farnell.com/panasonic-electronic-components/erj3ekf5362v/res-couche-epaisse-53-6k-1-0-1w/dp/2059475) | Résistance à puce CMS, Couche épaisse, 53.6 kohm, 75 V, 0603, 100 mW, ± 1%
 |  | R605 | 2k26 | 0603 |  | 75 |  |  | 0.1 | 1 | WALSIN | WR06X2261FTL | FARNELL | 2670701 (http://fr.farnell.com/walsin/wr06x2261ftl/res-couche-epaisse-2k26-1-0-1w/dp/2670701) | Résistance à puce CMS, 2.26 kohm, 75 V, 0603, 100 mW, ± 1%, WR06 Series
 |  | R606 | 113k | 0603 |  | 75 |  |  | 0.1 | 1 | WALSIN | WR06X1133FTL | FARNELL | 2670609 (http://fr.farnell.com/walsin/wr06x1133ftl/res-couche-epaisse-113k-1-0-1w/dp/2670609) | Résistance à puce CMS, 113 kohm, 75 V, 0603, 100 mW, ± 1%, WR06 Series
 |  | R607 | 10k | 0603 |  | 75 |  |  | 0.1 | 1 | VISHAY | CRCW060310K0JNEA | FARNELL | 2693095 (http://fr.farnell.com/vishay/crcw060310k0jnea/res-aec-q200-10k-5-0-1w-0603/dp/2693095) | Résistance à puce CMS, 10 kohm, 75 V, 0603, 100 mW, ± 5%, CRCW Series
 | R700 | R701 | 1Meg | 0603 |  | 50 |  |  | 0.1 | 1 | YAGEO | RC0603FR-071ML | FARNELL | 9238840 (http://fr.farnell.com/yageo-phycomp/rc0603fr-071ml/res-couche-epaisse-1m-1-0-1w-0603/dp/9238840) | Résistance à puce CMS, Couche épaisse, 1 Mohm, 50 V, 0603, 100 mW, ± 1%, Série RC
 |  | R702 | 1Meg | 0603 |  | 50 |  |  | 0.1 | 1 | YAGEO | RC0603FR-071ML | FARNELL | 9238840 (http://fr.farnell.com/yageo-phycomp/rc0603fr-071ml/res-couche-epaisse-1m-1-0-1w-0603/dp/9238840) | Résistance à puce CMS, Couche épaisse, 1 Mohm, 50 V, 0603, 100 mW, ± 1%, Série RC
 | R800 | R801 | 0 | 2512 | http://www.farnell.com/datasheets/2111203.pdf | 500 |  |  | 1 | 1 | VISHAY | CRCW25120000Z0EG | FARNELL | 2309110 (http://fr.farnell.com/vishay/crcw25120000z0eg/resistance-chip-jumper-zeror-1w/dp/2309110) | Résistance à puce CMS, Couche épaisse, 0 ohm, 500 V, 2512, 1 W, Série CRCW
 |  | R802 | 0 | 2512 | http://www.farnell.com/datasheets/2111203.pdf | 500 |  |  | 1 | 1 | VISHAY | CRCW25120000Z0EG | FARNELL | 2309110 (http://fr.farnell.com/vishay/crcw25120000z0eg/resistance-chip-jumper-zeror-1w/dp/2309110) | Résistance à puce CMS, Couche épaisse, 0 ohm, 500 V, 2512, 1 W, Série CRCW
 |  | R803 | 100k-1W | 2512 |  | 500 |  |  | 1 | 1 | VISHAY | CRCW2512100KFKEG. | FARNELL | 2395981 (http://fr.farnell.com/vishay/crcw2512100kfkeg/res-couche-epaisse-100k-1-1w-2512/dp/2395981) | Résistance à puce CMS, Couche épaisse, 100 kohm, 500 V, 2512 , 1 W, ± 1%, Série CRCW
Circuits Intégrés
 | U200 | U201 | LM317_TO263-3 | D²Pack | http://www.farnell.com/datasheets/1815554.pdf | 37 |  | 1.5 |  |  | ST Micro | LM317D2T-TR | FARNELL | 1564300 (http://fr.farnell.com/stmicroelectronics/lm317d2t-tr/ic-volt-reg-1-2v-37v-dpak-3/dp/1564300) | Régulateur de tension linéaire, Ajustable, Entrée primaire 40V, 1 sortie 1.2V à 37V, 2.2A, TO-263-3
 |  | U202 | TPS82130 | SIL0008C | http://www.ti.com/lit/ds/symlink/tps82130.pdf | 17 |  | 3 |  |  |  | TPS82130SILT | FARNELL | 2535383 (http://fr.farnell.com/texas-instruments/tps82130silt/conv-dc-dc-buck-3a-2mhz-usip-8/dp/2535383) | Régulateur DC/DC à découpage Buck (Step Down), Ajustable, 3V-17Vin, 900mV-5V/3A out, 2MHz, µSIP-8
 | U300 | U301 | TPS54622 | VQFN14 | http://www.ti.com/lit/ds/symlink/tps54622.pdf | 17 |  | 6 |  |  | Texas | TPS54622RHLT | FARNELL | 2323555 (http://fr.farnell.com/texas-instruments/tps54622rhlt/convertisseur-dc-dc-buck-1-6mhz/dp/2323555) | Régulateur DC/DC à découpage Buck (Step Down), Ajustable, 4.5V-17Vin, 600mV-15Vout, 6Aout, VQFN-14
 | U400 | U401 | LM3488 | VSSOP8 | http://www.ti.com/lit/ds/symlink/lm3488.pdf | 40 |  |  |  |  | Texas | LM3488MM/NOPB | FARNELL | 1469252 (http://fr.farnell.com/texas-instruments/lm3488mm-nopb/ic-n-ch-controller-vssop-8/dp/1469252) | Contrôleur DC/DC, Haute efficacité, 2.97V à 40V, 1 Sortie, Boost, Flyback, SEPIC, 1MHz, VSSOP-8
 | U500 | U501 | RaspPi3
 |  | U502 | Con_RaspPi3 | 20 x 2 x 2,54 | http://www.farnell.com/datasheets/2038897.pdf |  |  |  |  |  | Molex | 10-89-7402 | FARNELL | 2396214 | Connecteur carte-à-carte, 2.54 mm, 40 Contact(s), Embase, Série C-Grid 70280, Traversant
 |  | U503 | DS1302 | SO8 | http://www.farnell.com/datasheets/48496.pdf | 5 |  |  |  |  | MAXIM | DS1302Z+ | FARNELL | 2519519 (http://fr.farnell.com/maxim-integrated-products/ds1302z/rtc-trickle-charge-1302-soic8/dp/2519519) | Sauvegarde de temps, Format de date (Jour/Date/Mois/Année hh:mm:ss) 3 fils, Série, 2V à 5.5V, SOIC-8
 | U5600 | U601 | TPS54622 | VQFN14 | http://www.ti.com/lit/ds/symlink/tps54622.pdf | 17 |  | 6 |  |  | Texas | TPS54622RHLT | FARNELL | 2323555 (http://fr.farnell.com/texas-instruments/tps54622rhlt/convertisseur-dc-dc-buck-1-6mhz/dp/2323555) | Régulateur DC/DC à découpage Buck (Step Down), Ajustable, 4.5V-17Vin, 600mV-15Vout, 6Aout, VQFN-14
 | U700 | U701 | relais_1RT | MP-serie | http://www.farnell.com/datasheets/1785165.pdf | 12 |  | 0.012 |  |  | OPTO22 | MP240D4 | FARNELL | 7229082 (http://fr.farnell.com/opto-22/mp240d4/relais-statique-4a/dp/7229082) | Relais statique, SPST-NO, 4 A, 280 VAC, PCB, Traversant, Passage à zéro
 |  | U702 | relais_1RT | MP-serie | http://www.farnell.com/datasheets/1785165.pdf | 12 |  | 0.012 |  |  | OPTO22 | MP240D4 | FARNELL | 7229082 (http://fr.farnell.com/opto-22/mp240d4/relais-statique-4a/dp/7229082) | Relais statique, SPST-NO, 4 A, 280 VAC, PCB, Traversant, Passage à zéro
 | U800 | U801 | TCLT1000 | TCLT1000 | http://www.farnell.com/datasheets/2049543.pdf |  |  | 0.06 |  |  | VISHAY | TCLT1000 | FARNELL | 8310688 (http://fr.farnell.com/vishay/tclt1000/optocoupleur-sortie-transistor/dp/8310688) | Optocoupleur, Sortie transistor, 1 voie, SOP, 4 Broche(s), 60 mA, 5 kV, 50 %
Quartz
 | Y500 | Y501 | 32Khz | 7,9 x 3,7 | http://www.farnell.com/datasheets/1581184.pdf |  |  |  |  |  | CITIZEN | CM250C-32.000KAZF-UT | FARNELL | 2101355 (http://fr.farnell.com/citizen-finetech-miyota/cm250c-32-000kazf-ut/quartz-32khz-12-5pf-cms/dp/2101355) | Cristal, 32 kHz, CMS, 7.9mm x 3.7mm, 12.5 pF, 30 ppm, Série CM250C

Sheet: calcul
 |  | Reference | Value | Footprint | Datasheet | Tension | ESR | Courant | Puissance | Tolerance | Fabricant | REF Fab | Distributeur | Ref Distri | Description
 |  |  |  |  |  | V | mOhms | A | W | %
Batterie
 | BT500 | BT501 | 3V-Lit |  |  | 3.3
Condensateurs |  |  |  |  |  |  | 2
 | C200 | C201 | 22u | 2220 |  | 25 | 3 |  |  | 10 | KEMET | C2220X226K3RACAUTO | FARNELL | 2478282 (http://fr.farnell.com/kemet/c2220x226k3racauto/condensateur-mlcc-x7r-22uf-25v/dp/2478282) | Condensateur céramique multicouche CMS, 2220, 22 µF, 25 V, ± 10%, X7R
 |  | C202 | 22uF | 1206 |  | 16 |  |  |  | 20 | AVX | 1206YD226MAT2A | FARNELL | 1833823 (http://fr.farnell.com/avx/1206yd226mat2a/condensateur-mlcc-x5r-22uf-16v/dp/1833823) | Condensateur céramique multicouche CMS, 1206, 22 µF, 16 V, ± 20%, X5R
 |  | C203 | 15F | C pas 5,5 |  | 2.7 | 35 |  |  |  | AVX | SCCT30B156SRB | FARNELL | 2696615 (http://fr.farnell.com/axiohm/scct30b156srb/super-condensateur-15f-2-7v-radial/dp/2696615) | Supercondensateur, 15 F, 2.7 V, SCC Series, +30%, -10%, À sorties radiales
 |  | C204 | 15F | C pas 5,5 |  | 2.7 | 35 |  |  |  | AVX | SCCT30B156SRB | FARNELL | 2696615 (http://fr.farnell.com/axiohm/scct30b156srb/super-condensateur-15f-2-7v-radial/dp/2696615) | Supercondensateur, 15 F, 2.7 V, SCC Series, +30%, -10%, À sorties radiales
 |  | C205 | 15F | C pas 5,5 |  | 2.7 | 35 |  |  |  | AVX | SCCT30B156SRB | FARNELL | 2696615 (http://fr.farnell.com/axiohm/scct30b156srb/super-condensateur-15f-2-7v-radial/dp/2696615) | Supercondensateur, 15 F, 2.7 V, SCC Series, +30%, -10%, À sorties radiales
 |  | C206 | 15F | C pas 5,5 |  | 2.7 | 35 |  |  |  | AVX | SCCT30B156SRB | FARNELL | 2696615 (http://fr.farnell.com/axiohm/scct30b156srb/super-condensateur-15f-2-7v-radial/dp/2696615) | Supercondensateur, 15 F, 2.7 V, SCC Series, +30%, -10%, À sorties radiales
 |  | C207 | 22uF | 2220 |  | 25 | 3 |  |  | 10 | KEMET | C2220X226K3RACAUTO | FARNELL | 2478282 (http://fr.farnell.com/kemet/c2220x226k3racauto/condensateur-mlcc-x7r-22uf-25v/dp/2478282) | Condensateur céramique multicouche CMS, 2220, 22 µF, 25 V, ± 10%, X7R
 |  | C208 | 680p | 0603 |  | 100 |  |  |  |  | Multicomp | MC0603B681K101CT | FARNELL | 1759134 (http://fr.farnell.com/multicomp/mc0603b681k101ct/condensateur-mlcc-x7r-680pf-100v/dp/1759134) | Condensateur céramique multicouche CMS, 0603, 680 pF, 100 V, ± 10%, X7R, Série MC
 |  | C209 | 6p | 0603 |  | 25 |  |  |  |  | Multicomp | MC0603N6R0D500CT | FARNELL | 1759047 (http://fr.farnell.com/multicomp/mc0603n6r0d500ct/condensateur-mlcc-c0g-np0-6pf/dp/1759047) | Condensateur céramique multicouche CMS, 0603, 6 pF, 50 V, ± 0.5pF, C0G / NP0
 |  | C210 | 47uF | 1206 |  | 10 | 3 |  |  |  | KEMET | C1206C476M8PACTU | FARNELL | 1572639 (http://fr.farnell.com/kemet/c1206c476m8pactu/condensateur-mlcc-x5r-47uf-10v/dp/1572639) | Condensateur céramique multicouche CMS, 1206, 47 µF, 10 V, ± 20%, X5R, Série C
 | C300 | C301 | 22u
 |  | C302 | 4u7
 |  | C303 | 43p
 |  | C304 | 9n1
 |  | C305 | 100n
 |  | C306 | 51p
 |  | C307 | 2n7
 |  | C308 | 22p
 |  | C309 | 22u |  |  | 10
 | C400 | C401 | 47u
 |  | C402 | 100n
 |  | C403 | 1n5
 |  | C404 | 27n
 |  | C405 | 10n
 |  | C406 | 82u |  |  |  | 20
 |  | C407 | 82u |  |  |  | 20
 |  | C408 | 100n |  |  | 50
 | C500 | C501 | 1u
 |  | C502 | 6p
 |  | C503 | 6p
 |  | C504 | 1uF
 | C600 | C601 | 22u
 |  | C602 | 4u7
 |  | C603 | 43p
 |  | C604 | 56n
 |  | C605 | 100n
 |  | C606 | 110p
 |  | C607 | 2n7
 |  | C608 | 22p
 |  | C609 | 22u 10v |  |  | 10
 | C700 | C701 | 10u
 |  | C702 | 10u
 | C800 | C801 | 33n |  |  | X2-300
 |  | C802 | 100n
 |  | C803 | 10u |  |  | 5
Diodes
 | D100 | D101 | BAS16
 | D200 | D201 | D_ALT | PowerDI123 | http://www.farnell.com/datasheets/2096657.pdf | 40 |  | 2 |  |  | Diodes Inc | SBR2A40P1-7 | FARNELL | 1713961 (http://fr.farnell.com/diodes-inc/sbr2a40p1-7/redresseur-super-b-powerdi-123/dp/1713961) | Diode de récupération standard, POWERDI®, 40 V, 2 A, Une, 500 mV, 50 A
 |  | D202 | D_ALT | PowerDI123 | http://www.farnell.com/datasheets/2096657.pdf | 40 |  | 2 |  |  | Diodes Inc | SBR2A40P1-7 | FARNELL | 1713961 (http://fr.farnell.com/diodes-inc/sbr2a40p1-7/redresseur-super-b-powerdi-123/dp/1713961) | Diode de récupération standard, POWERDI®, 40 V, 2 A, Une, 500 mV, 50 A
 | D400 | D401 | MBRD835LT4G
 | D500 | D501 | Zener-3V3 |  |  | 3.3
 | D700 | D701 | 1N9001
 |  | D702 | 1N9001
 | D800 | D801 | 1N4001
Inductances
 | L300 | L301 | 2u7 |  |  |  | 12
 | L400 | L401 | SRP1270-100M |  |  |  | 100
 | L600 | L601 | 6u8 |  |  |  | 40
Connecteurs
 | P100 | P101 | Master-12V |  |  | 12
 |  | P102 | detection-230V |  |  | 230
 |  | P103 | Secteur |  |  | 230
 |  | P104 | Secteur |  |  | 230
 |  | P105 | 2Pts-CANON 1200D |  |  | 7.4
 |  | P106 | 2Pts-Flash |  |  | 6.5
 |  | P107 | 2Pts-shutter |  |  | 6.5
 |  | P108 | Bouton Poussoir |  |  | 5
 |  | P109 | HT910-E |  |  | 12
 |  | P110 | GACHE |  |  | 12
 |  | P111 | 24V-PRINT |  |  | 24
 | P500 | P501 | alim |  |  | 5
Transistors
 | Q100 | Q101 | Q_NMOS_GSD
 | Q300 | Q301 | Q_NMOS_GSD
 | Q400 | Q401 | CSD17579Q3A
 | Q500 | Q501 | Q_NMOS_GSD
 | Q700 | Q701 | Q_NMOS_GSD
 |  | Q702 | Q_NMOS_GSD
Resistances
 | R100 | R101 | 1Meg
 | R200 | R202 | 0
 |  | R201 | 0
 |  | R203 | 240
 |  | R204 | 523k
 |  | R205 | 10k
 |  | R206 | 10k
 |  | R207 | 10k
 |  | R208 | 10k
 |  | R209 | 100k
 |  | R210 | 523k
 |  | R211 | 100k
 | R300 | R301 | 0
 |  | R302 | 105k
 |  | R303 | 37k
 |  | R304 | 53k6
 |  | R305 | 1Meg
 |  | R306 | 3k92
 |  | R307 | 97k6
 |  | R308 | 10k
 | R400 | R401 | 0
 |  | R402 | 100
 |  | R403 | 100
 |  | R404 | 100
 |  | R405 | 8mo-1W
 |  | R406 | 18k2
 |  | R407 | 1k
 | R500 | R501 | 47k
 |  | R502 | 300R
 |  | R503 | 1Meg
 |  | R504 | 100k
 |  | R505 | 100k
 |  | R506 | 100k
 | R600 | R601 | 0
 |  | R602 | 105k
 |  | R603 | 37k
 |  | R604 | 53k6
 |  | R605 | 2k26
 |  | R606 | 113k
 |  | R607 | 10k
 | R700 | R701 | 1Meg
 |  | R702 | 1Meg
 | R800 | R801 | 0
 |  | R802 | 0
 |  | R803 | 100k-1W
Circuits Intégrés
 | U200 | U201 | LM317_SOT223 | D²Pack | http://www.farnell.com/datasheets/1815554.pdf | 37 |  | 1.5
 |  | U202 | TPS82130
 | U300 | U301 | TPS54622
 | U400 | U401 | LM3488
 | U500 | U501 | RaspPi3
 |  | U502 | Con_RaspPi3
 |  | U503 | DS1302
 | U5600 | U601 | TPS54622
 | U700 | U701 | relais_1RT
 |  | U702 | relais_1RT
 | U800 | U801 | TCLT1000
Quartz
 | Y500 | Y501 | 32Khz

Sheet: Feuille3
R1 | 240
R2 | 1650
Vout | 10.00875
