Postcard/figure-electronics/wiring/kicad/Plan cablage bretelles_V3.4.xls

N° | À fournir | NOM | Terminal A | Repère | carte mere | Connecteur PCB | Connecteur A | Nom câble | Repère câble | PIN | Signal | couleur | Câble Type | REF | Longueur | PIN | Couleur | Connecteur B | Terminal B | Repère
1 | Non | Câble GSM | HT910-E | U2 |  |  | FME | 1-câble GSM |  | Pin | Gsm |  | Coaxial | RG 174 / U | 100cm | Pin |  | SMA | ANT-WIFI-GSM | U3
 |  |  |  |  |  | HT910-E |  |  |  | Tresse |  |  |  |  |  | Tresse
2 | Non | Câble Wifi |  | U5 |  |  | SMA | 2-Câble WiFi |  | Pin | WiFi |  | Coaxial | RG 174 / U | 100cm | Pin |  | SMA | ANT-WIFI-GSM | U3
 |  |  |  |  |  | Dongle WiFi |  |  |  | Tresse |  |  |  |  |  | Tresse
3 | Non | USB HT910-E | HT910-E | U2 |  |  | Mini A/B USB | 3-USB HT910-E |  | 1 | Vusb | rouge | 4 x AWG28 | AWG28 blindé | 30cm | 1 | rouge | USB type A | Raspberry-PI 3 | U7
 |  |  |  |  |  | HT910-E |  |  |  | 2 | D- | vert |  | 2 conducteurs droits |  | 2 | vert
 |  |  |  |  |  |  |  |  |  | 3 | D+ | blanc |  | 2 conducteurs spiralés |  | 3 | blanc | USB1
 |  |  |  |  |  |  |  |  |  | 4 | nc | nc |  |  |  | 4 | nc
 |  |  |  |  |  |  |  |  |  | 5 | GND | tresse/noir |  |  |  | 5 | tresse/noir
4 | Oui | Alim HT910-E | HT910-E | U2 |  |  | RJ11 | 4-Alim HT910-E |  | 1 | Vcc | Blanc | 3 x AWG26 | 3 x AWG26 | 50cm | 1 | Blanc | RJ11 | Carte mère | U8
 |  |  |  |  |  | HT910-E | 6P6C |  |  | 2 | nc |  |  | 3 conducteurs droits |  | 2 |  | 6P6C | RS 848-6705
 |  |  |  |  |  |  |  |  |  | 3 | nc |  |  |  |  | 3
 |  |  |  |  |  |  |  |  |  | 4 | TO_IN | Rouge |  |  |  | 4 | Rouge
 |  |  |  |  |  |  |  |  |  | 5 | nc |  |  |  |  | 5
 |  |  |  |  |  |  |  |  |  | 6 | GND | Noir |  |  |  | 6 | Noir
5 | Non | USB WiFi dongle |  | U5 |  |  | Mini A/B USB | 5-USB WiFi |  | 1 | Vusb | rouge |  | connexion directe | 20cm | 1 | rouge | USB type A | Raspberry-PI 3 | U7
 |  |  |  |  |  | Dongle WiFi |  |  |  | 2 | D- | vert |  |  |  | 2 | vert
 |  |  |  |  |  |  |  |  |  | 3 | D+ | blanc |  |  |  | 3 | blanc | USB2
 |  |  |  |  |  |  |  |  |  | 4 | nc | nc |  |  |  | 4 | nc
 |  |  |  |  |  |  |  |  |  | 5 | GND | tresse/noir |  |  |  | 5 | tresse/noir
6 | Non | Ethernet classique B | Trough | U1 |  | Traversée Ethernet | RJ45 | 6-Ethernet |  | 1 | Vcc | orange/blanc | 8 x AWG24 | AWG24 blindé | 50cm | 1 | orange/blanc | RJ45 | Raspberry-PI 3 | U7
 |  |  |  |  |  | FAR 2518206 |  |  |  | 2 | nc | orange |  | 4 paires torsadées |  | 2 | orange
 |  |  |  |  |  |  |  |  |  | 3 | nc | Vert/blanc |  |  |  | 3 | Vert/blanc
 |  |  |  |  |  |  |  |  |  | 4 | TO_IN | bleu |  |  |  | 4 | bleu
 |  |  |  |  |  |  |  |  |  | 5 | nc | Bleu/blanc |  |  |  | 5 | Bleu/blanc
 |  |  |  |  |  |  |  |  |  | 6 | GND | Vert |  |  |  | 6 | Vert
 |  |  |  |  |  |  |  |  |  | 7 | nc | Marron/blanc |  |  |  | 7 | Marron/blanc
 |  |  |  |  |  |  |  |  |  | 8 | GND | Marron/blanc |  |  |  | 8 | Marron/blanc
7 | Oui | Master 12V | Alim 12V@180W | U4 | Alim 12V | bornier | Cosse rouge ouverte 1863559 FAR | 7-Master 12V |  | +V | +12V | Rouge | 2 x 3mm² | AWG12 | 40cm | 1 | Rouge | Vdc-IN | Carte Mère | U8
 |  |  |  |  |  |  | Cosse noire ouverte 2456373 FAR |  |  | COM | 0V/GND | Noir |  | AWG12 |  | 2 | Noir | RS 122-4897 | P101 / RS 122-4903
8 | Oui | Alimentation RPI3 | Carte mère | U8 | Alim 5V | Carte mère | Embout de câble vissé | 8-Alim RPI3 |  | 1 | Vusb | rouge | 2 x AWG24 | AWG24 | 20cm | 1 | rouge | Micro-USB B | Raspberry-PI 3 | U7
 |  |  |  |  |  | RS 826-7214 |  |  |  |  | D- | nc |  | 2 conducteurs droits |  | 2 | nc
 |  |  |  |  | P501 | Bornier |  |  |  |  | D+ | nc |  |  |  | 3 | nc
 |  |  |  |  |  |  |  |  |  |  | nc | nc |  |  |  | 4 | nc
 |  |  |  |  |  |  | Embout de câble vissé |  |  | 2 | GND | Noir |  |  |  | 5 | Noir
9 | Non | USB 1200D | Carte mère | U7 |  |  | USB type A | 9-USB 1200D |  | 1 | Vusb | rouge | 4 x AWG28 | AWG28 blindé | 50cm | 1 | rouge | Micro USB type B | Raspberry-PI 3 | U14
 |  |  |  |  |  |  |  |  |  | 2 | D- | vert |  | 2 conducteurs droits |  | 2 | vert
 |  |  |  |  |  |  |  |  |  | 3 | D+ | blanc |  | 2 conducteurs spiralés |  | 3 | blanc
 |  |  |  |  |  |  |  |  |  | 4 | nc | nc |  |  |  | 4 | nc
 |  |  |  |  |  |  |  |  |  | 5 | GND | tresse/noir |  |  |  | 5 | tresse/noir
10 | Non | USB Print | Carte mère | U8 |  |  | USB Type A | 10-USB Print |  | 1 | Vusb | rouge | 4 x AWG28 | AWG28 blindé | 60cm | 1 | rouge | USB | Raspberry-PI 3 | U15
 |  |  |  |  |  |  |  |  |  | 2 | D- | vert |  | 2 conducteurs droits |  | 2 | vert
 |  |  |  |  |  |  |  |  |  | 3 | D+ | blanc |  | 2 conducteurs spiralés |  | 3 | blanc
 |  |  |  |  |  |  |  |  |  | 4 | nc | nc |  |  |  | 4 | nc
 |  |  |  |  |  |  |  |  |  | 5 | GND | tresse/noir |  |  |  | 5 | tresse/noir
11 | Oui | Alim Flash | Carte Mère | U8 | Flash | Carte mère | RS 825-0828 | 11-Alim Flash |  | 1 | +6,5V | Rouge | 2 x 1mm² |  | 60cm | Fausse pile | Rouge | Extrêmités libres | Flash | U13
 |  |  |  |  | P106 | RS 824-6658 | Pas 3,81 2 pts |  |  | 2 | 0V/GND | Noir |  |  |  | Fausse pile | Noir
12 | Oui | Combi 1200D | Carte Mère | U8 | 1200D | Carte mère | RS 825-0830 | 12-Combi 1200D |  | 1 | +7,4V | Rouge | 2 x 1mm² |  | 60cm | Pin | Rouge | Connecteur Mâle coudé BKL Electronic 072614 |  | U14
 |  |  |  |  |  | RS 824-6655 | Pas 3,81 4 pts |  |  | 2 | 0V/GND | Noir |  |  |  | Tresse | Noir | Ø extérieur: 3 mm Ø intérieur: 1.1 mm
 |  |  |  |  |  | 4 pts
 |  |  |  |  |  |  |  |  |  | 3 | Shutter | Jaune | 2 x 0,3mm² |  |  | Pin | Jaune | Jack 2,5 |  | U14
 |  |  |  |  |  |  |  |  |  | 4 | 0V/GND | Noir |  |  |  | Tresse | Noir
13 | Oui | BP | Carte Mère | U8 | BP | RS 122-4921 | RS 122-4915 | 13-BP |  | 1 | BP | Marron | 2 x 0,3mm² |  | 30cm | soudure | Marron | Extrêmités libres |  | SW1
 |  |  |  |  |  | 2pts 2,5mm | 2pts 2,5mm |  |  | 2 | 0V/GND | Noir |  |  |  | soudure | Noir
14 | Oui | Alim Print | Carte Mère | U8 |  | RS 824-6636 | RS 825-0806 | 14-Alim Print |  | 1 | +24V | Rouge | 2 x 1mm² |  | 60cm |  | Rouge | Connecteur MOLEX 2pts 39-01-2025 |  | U15
 |  |  |  |  |  | 2 pts 3,5mm | 2 pts 3,5mm |  |  | 2 | 0V/GND | Noir |  |  |  |  | Noir
 |  |  |  |  |  | codage | RS 823-6327
15 | Oui | Alim Gâche | Carte Mère | U8 |  | RS 824-6636 | RS 825-0806 | 15-Alim Gâche |  | 1 | +6,5V | Rouge | 2 x 1mm² |  | 50cm |  | Rouge | Extrêmités libres |  | G1
 |  |  |  |  |  | 2 pts 3,5mm | 2 pts 3,5mm |  |  | 2 | 0V/GND | Noir |  |  |  |  | Noir
 |  |  |  |  |  | codage | RS 823-6327
L1 | Oui | Line 1 | Alimentation 12V | U4 |  |  | cosse ouverte fourche M4 rouge |  |  | L |  | Marron | 3 x 1mm² | AWG 20 ou 18 | 40cm |  | Marron | FASTON Mâle/femelle rouge 160834-02 | Filtre IEC | U6
 |  |  |  |  |  |  | cosse ouverte fourche M4 bleu |  |  | N |  | Bleu |  | AWG 20 ou 18 |  |  | Bleu | FASTON Mâle/femelle bleu 160834-02 | RS 167-6793
 |  |  |  |  |  |  | cosse ouverte fourche M4 jaune |  |  | T |  | Vert/jaune |  | AWG 20 ou 18 |  |  | Vert/jaune | FASTON Mâle/femelle jaune 160834-02
L2 | Oui | Line 2 | Filtre IEC | U6 |  |  | FASTON Femelle rouge |  |  | L |  | Marron | 3 x 1mm² | AWG 20 ou 18 | 40cm |  | Marron | RS 824-6673 | Carte Mère | U8
 |  |  | RS 167-6793 |  |  |  | FASTON Femelle Bleu |  |  | N |  | Bleu |  | AWG 20 ou 18 |  |  | Bleu | codage RS 823-6323 | RS 826-7481
 |  |  |  |  |  |  | FASTON Mâle/Femelle jaune |  |  | T |  | Vert/jaune |  | AWG 20 ou 18 |  |  | Vert/jaune
L3 | Oui | Line 3 | Alimentation 12V | U4 |  |  | cosse ouverte fourche M4 rouge |  |  | L |  | Marron | 3 x 1mm² | AWG 20 ou 18 | 60cm |  | Marron | vissage | Service 230 | U9
 |  |  |  |  |  |  | cosse ouverte fourche M4 bleu |  |  | N |  | Bleu |  | AWG 20 ou 18 |  |  | Bleu | vissage
 |  |  |  |  |  |  | cosse ouverte fourche M4 jaune |  |  | T |  | Vert/jaune |  | AWG 20 ou 18 |  |  | Vert/jaune | vissage
Terre | Oui | Terre | Filtre IEC | U6 |  |  | FASTON Mâle/Femelle jaune |  |  | T |  | Vert/jaune | 1mm² | AWG 20 ou 18 | 30cm |  | Vert/jaune | cosse ronde M4 jaune | Terre Tolerie
 |  |  | RS 167-6793
Terre | Oui | Reprise Terre | Alimentation 12V | U4 |  |  | cosse ouverte fourche M4 jaune |  |  | GND |  | Vert/jaune | 1mm² | AWG 20 ou 18 | 10cm | 0V/Com | Vert/jaune | cosse ouverte fourche M4 jaune | Alimentation 12V | U4
L3 | Oui | 230V out1 | carte mere | U8 | 230V out1 | RS 826-7481 | RS 824-6673 |  |  | L |  | Marron | 3 x 1mm² | AWG 20 ou 18 | 50cm |  | Marron | FASTON femelle rouge | Fiche IEC RS 539-2168 | U11
 |  |  |  |  |  |  | codage RS 823-6323
 |  |  |  |  |  |  |  |  |  | L |  | Marron | 3 x 1mm² | AWG 20 ou 18 | 30cm |  | Marron | cosse ouverte fourche M4 rouge | Alimentation 12V | U4
 |  |  |  |  |  |  |  |  |  | T |  | Vert/jaune |  | AWG 20 ou 18 |  |  | Vert/jaune | cosse ouverte fourche M4 jaune
L3 | Oui | 230V out2 | carte mere | U8 | 230V out2 | RS 826-7481 | RS 824-6673 |  |  | L |  | Marron | 3 x 1mm² | AWG 20 ou 18 | 50cm |  | Marron | FASTON femelle rouge | Fiche IEC RS 539-2168 | U12
 |  |  |  |  |  |  | codage RS 823-6323
 |  |  |  |  |  |  |  |  |  | L |  | Marron | 3 x 1mm² | AWG 20 ou 18 | 30cm |  | Marron | cosse ouverte fourche M4 rouge | Alimentation 12V | U4
 |  |  |  |  |  |  |  |  |  | T |  | Vert/jaune |  | AWG 20 ou 18 |  |  | Vert/jaune | cosse ouverte fourche M4 jaune
L3 | Oui | Line3 | Service 230 | U9 |  |  |  |  |  |  |  |  | 3 x 1mm² |  | 30cm |  |  |  | Fiche IEC | U11
 |  |  |  |  |  |  | vissage |  |  | N |  | Bleu |  | AWG 20 ou 18 |  |  | Bleu | FASTON Mâle/femelle rouge 160834-02 | RS 539-2168
 |  |  |  |  |  |  | vissage |  |  | T |  | Vert/jaune |  | AWG 20 ou 18 |  |  | Vert/jaune | FASTON Mâle/femelle bleu 160834-02
L3 | Oui | Line3 | Fiche IEC | U11 |  |  |  |  |  |  |  |  | 3 x 1mm² |  | 10cm |  |  |  | Fiche IEC | U12
 |  |  | RS 539-2168 |  |  |  | FASTON femelle bleu |  |  | N |  | Bleu |  |  |  |  | Bleu | FASTON femelle bleu | RS 539-2168
 |  |  |  |  |  |  | FASTON femelle jaune |  |  | T |  | Vert/jaune |  | AWG 20 ou 18 |  |  | Vert/jaune | FASTON femelle jaune
