Postcard/figure-electronics/wiring/kicad/cablage USB-Ethernet.odt

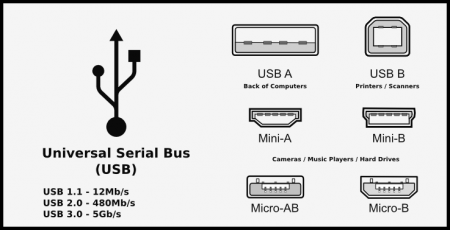
[picture p1: figure]
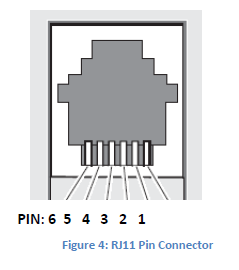
[picture p2: figure]
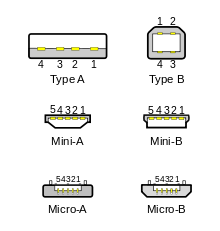
[picture p3: figure]
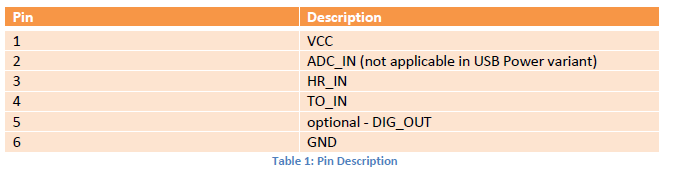
[picture p4: figure]
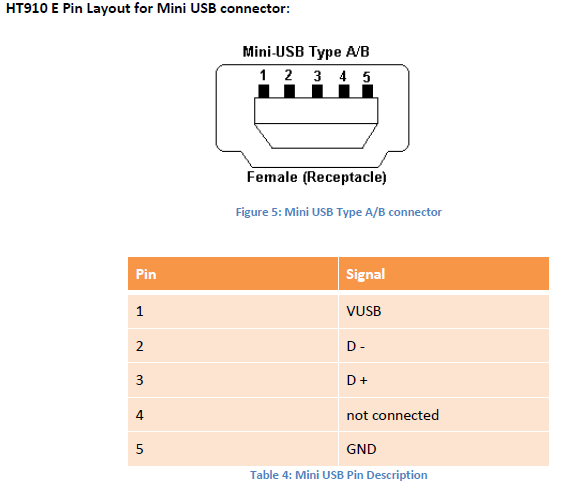
[picture p5: figure]
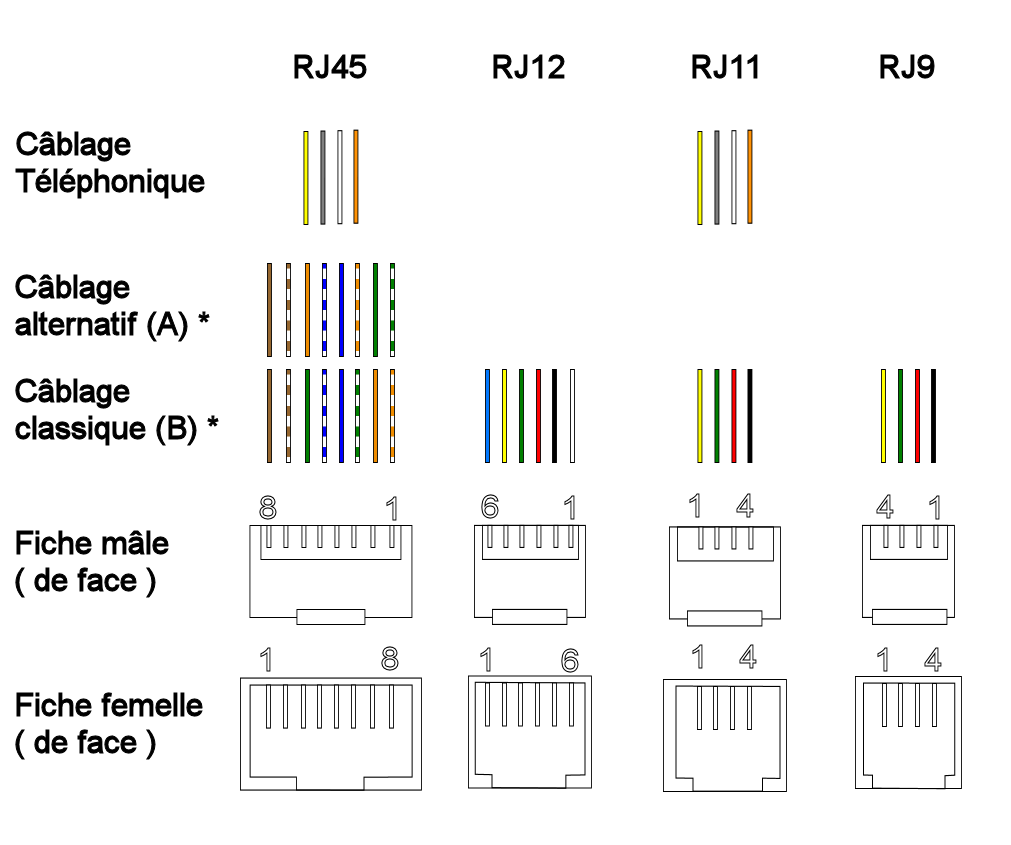
[picture p6: figure]
