Postcard/figure-electronics/wiring/kicad/Cablage_points.pdf

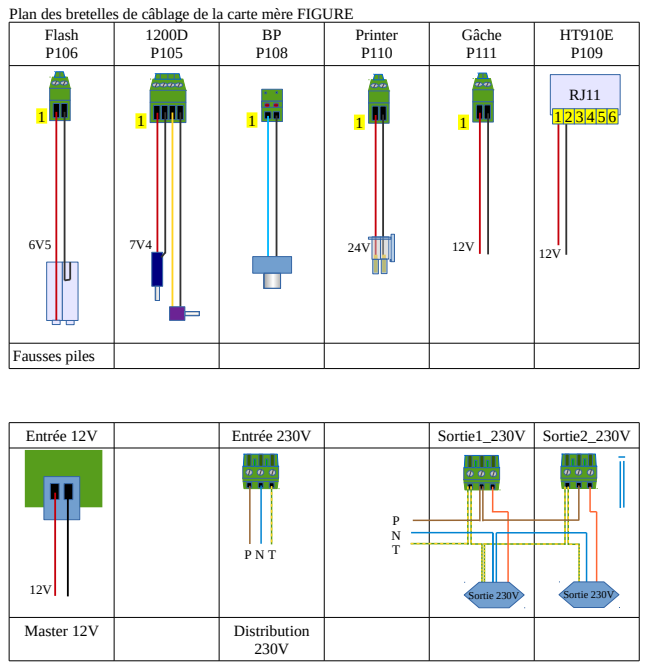
[picture p7: page 1]
Printer P110; Gâche P111; Fausses piles; Entrée 12V; Entrée 230V; Sortie1_230V; Sortie2_230V; Master 12V; Distribution; Sortie 230V; Sortie 230V 12V

Plan des bretelles de câblage de la carte mère FIGURE
Flash
