Postcard/figure-electronics/wiring/cablage.pdf

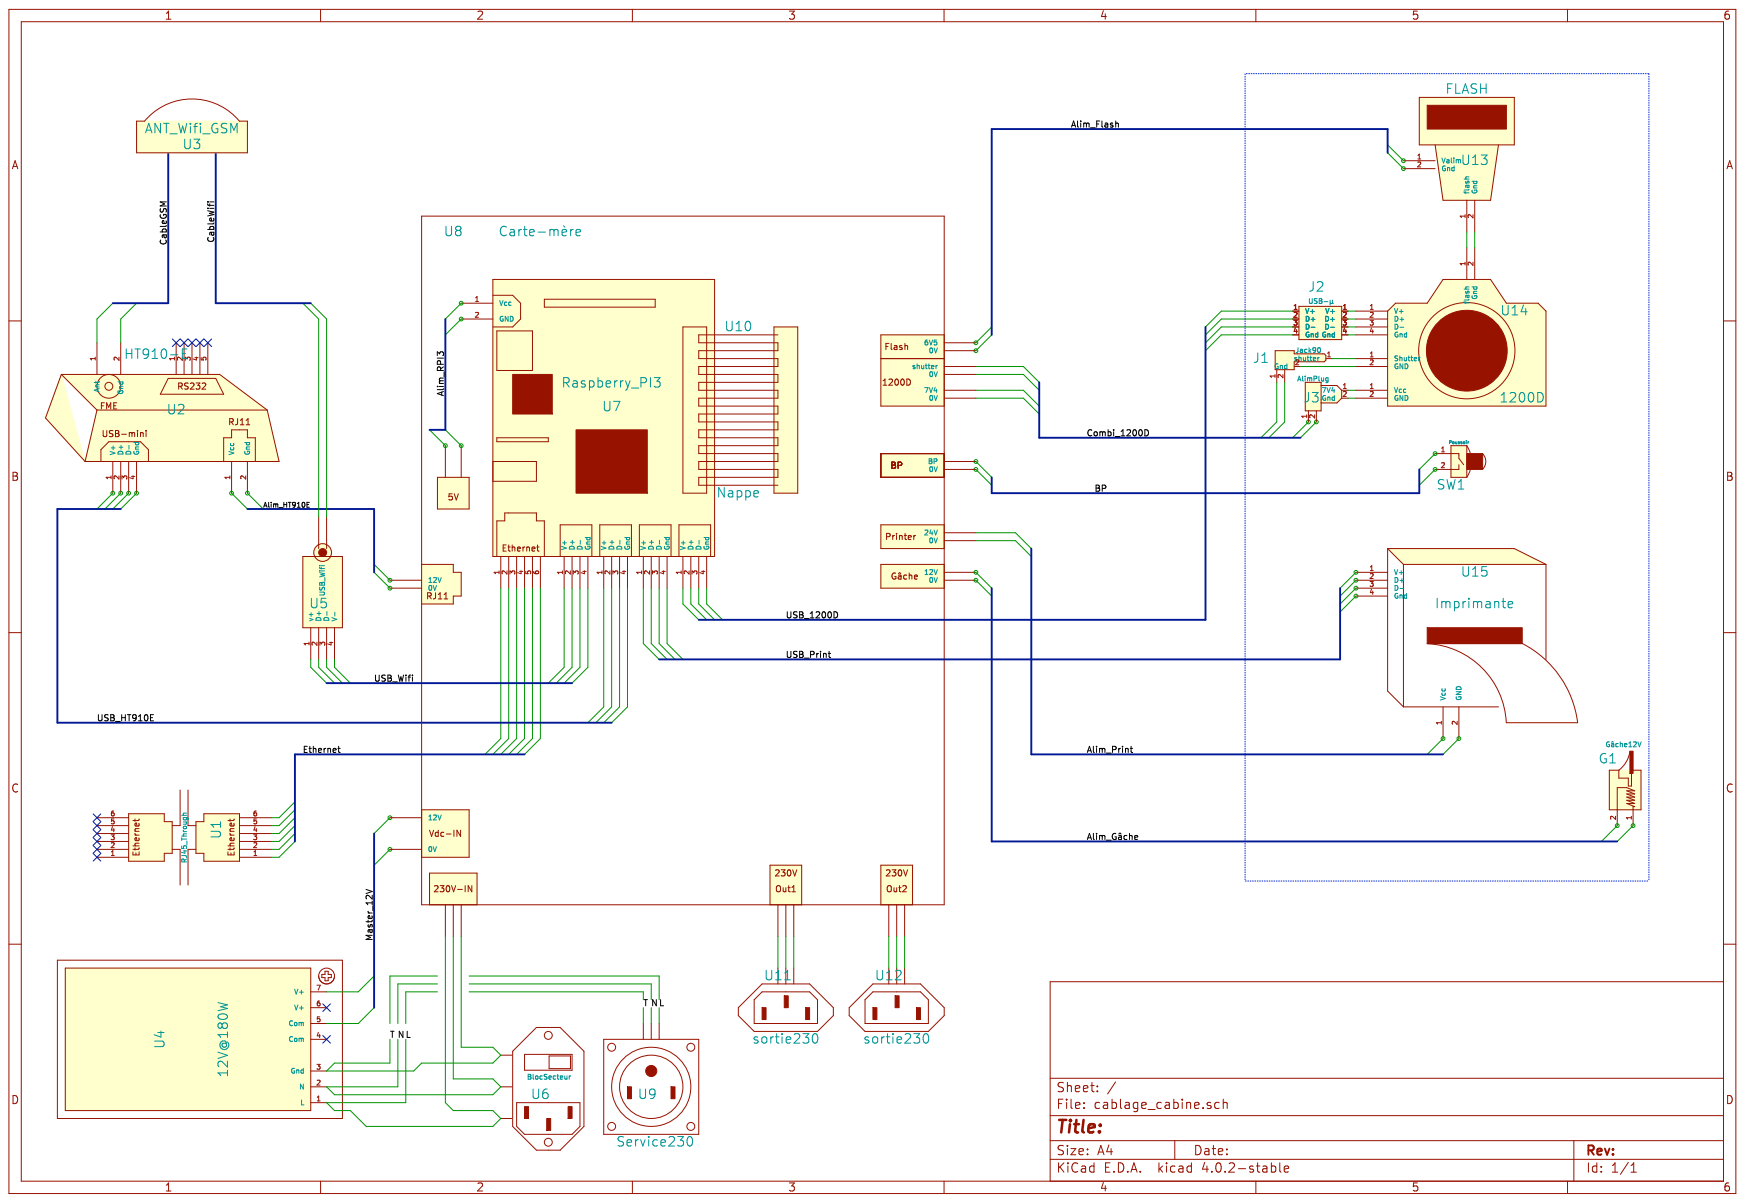
[picture p8: page 1]
