Postcard/figure-electronics/wiring/kicad/cablage_cabine_V3.1.pdf

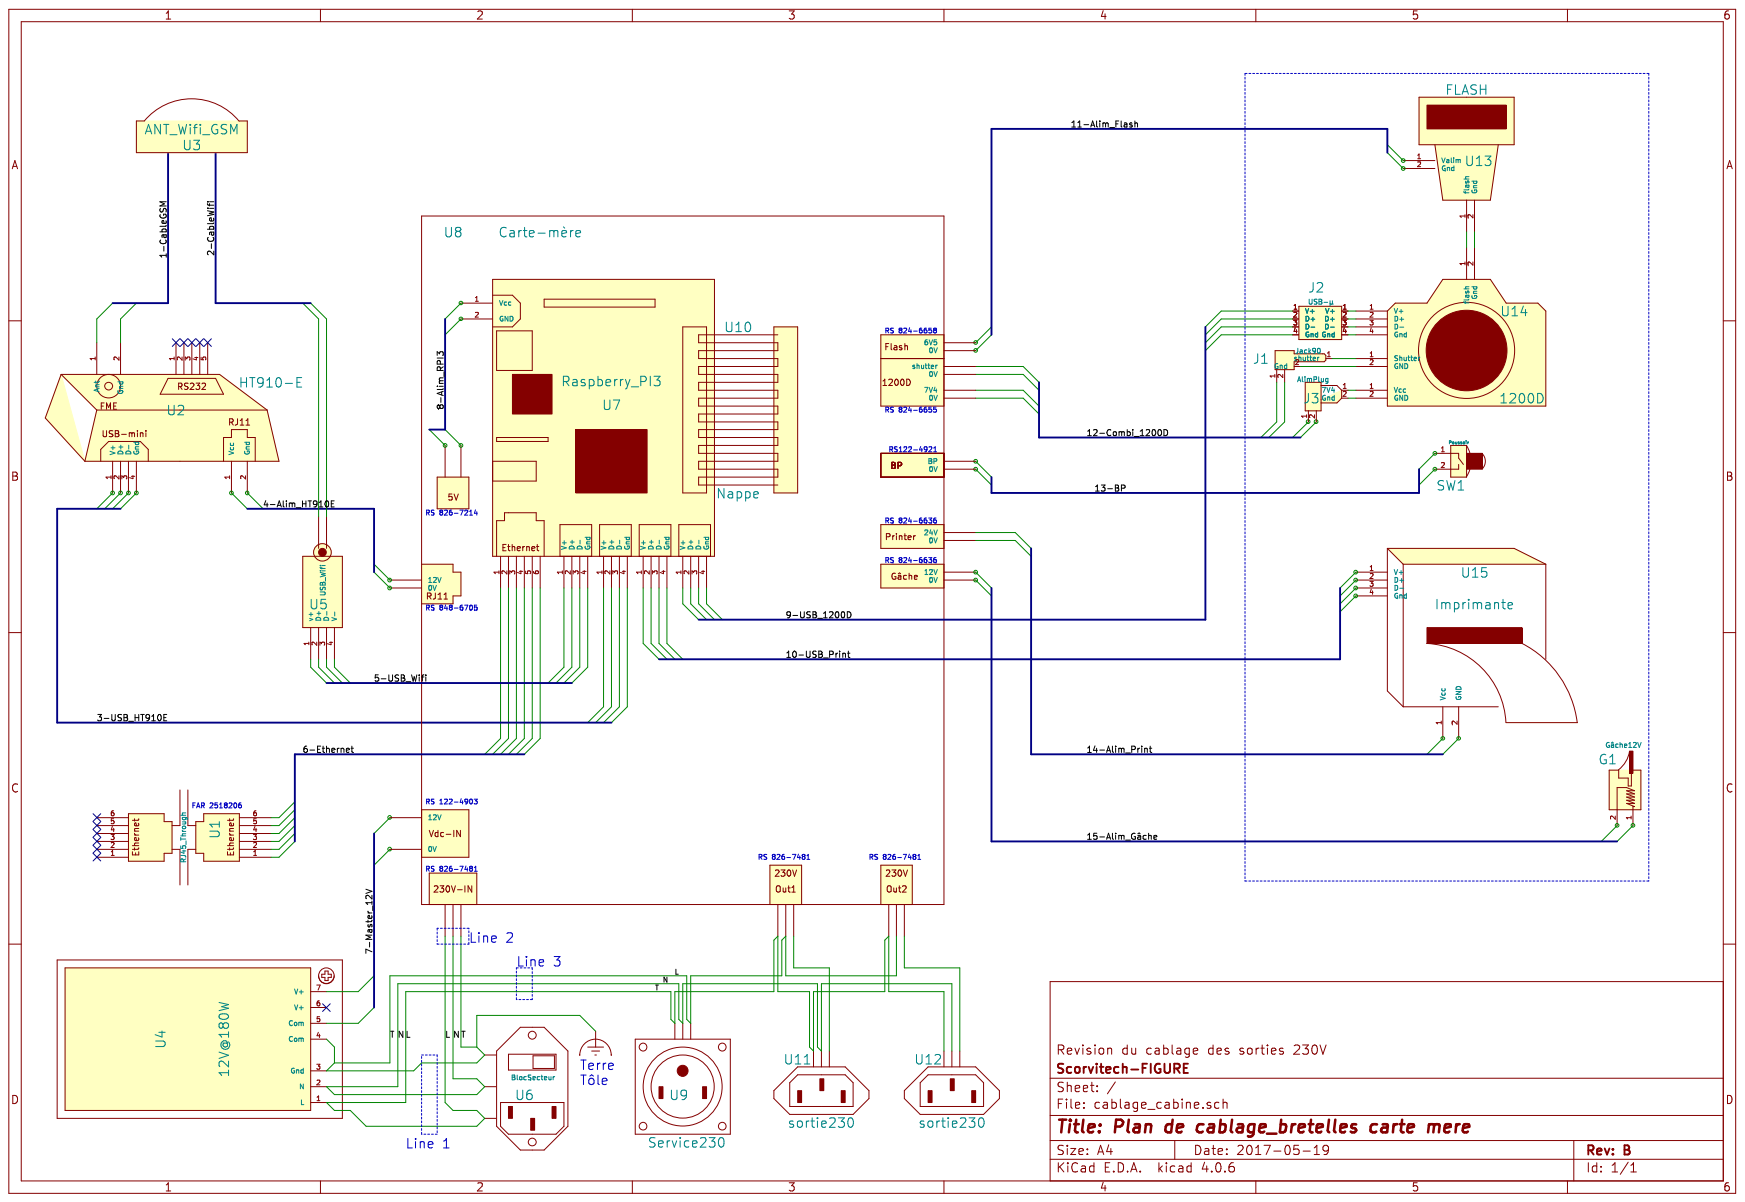
[picture p9: page 1]
