Postcard/figure-electronics/motherboard/placement provisoire carte mere Figure.pdf

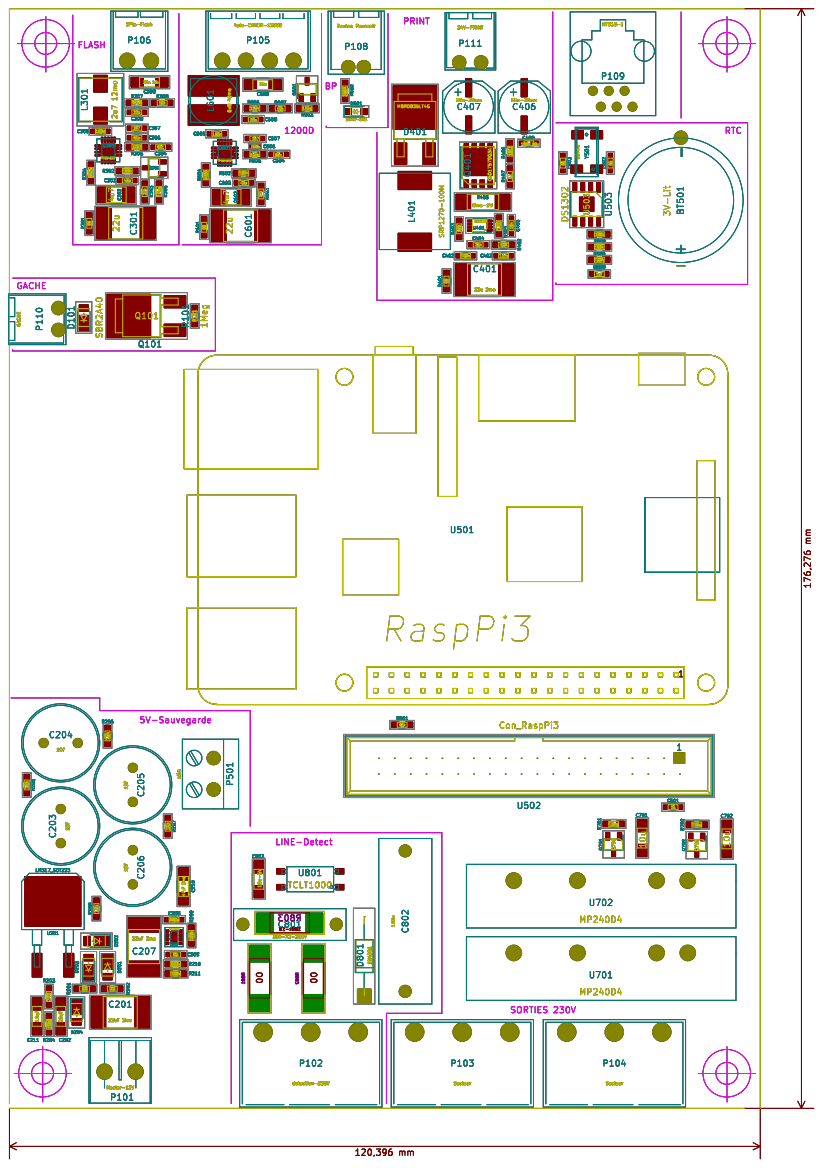
[picture p10: page 1]
