Postcard/figure-electronics/wiring/kicad/Cablage_cabine_V3.pdf

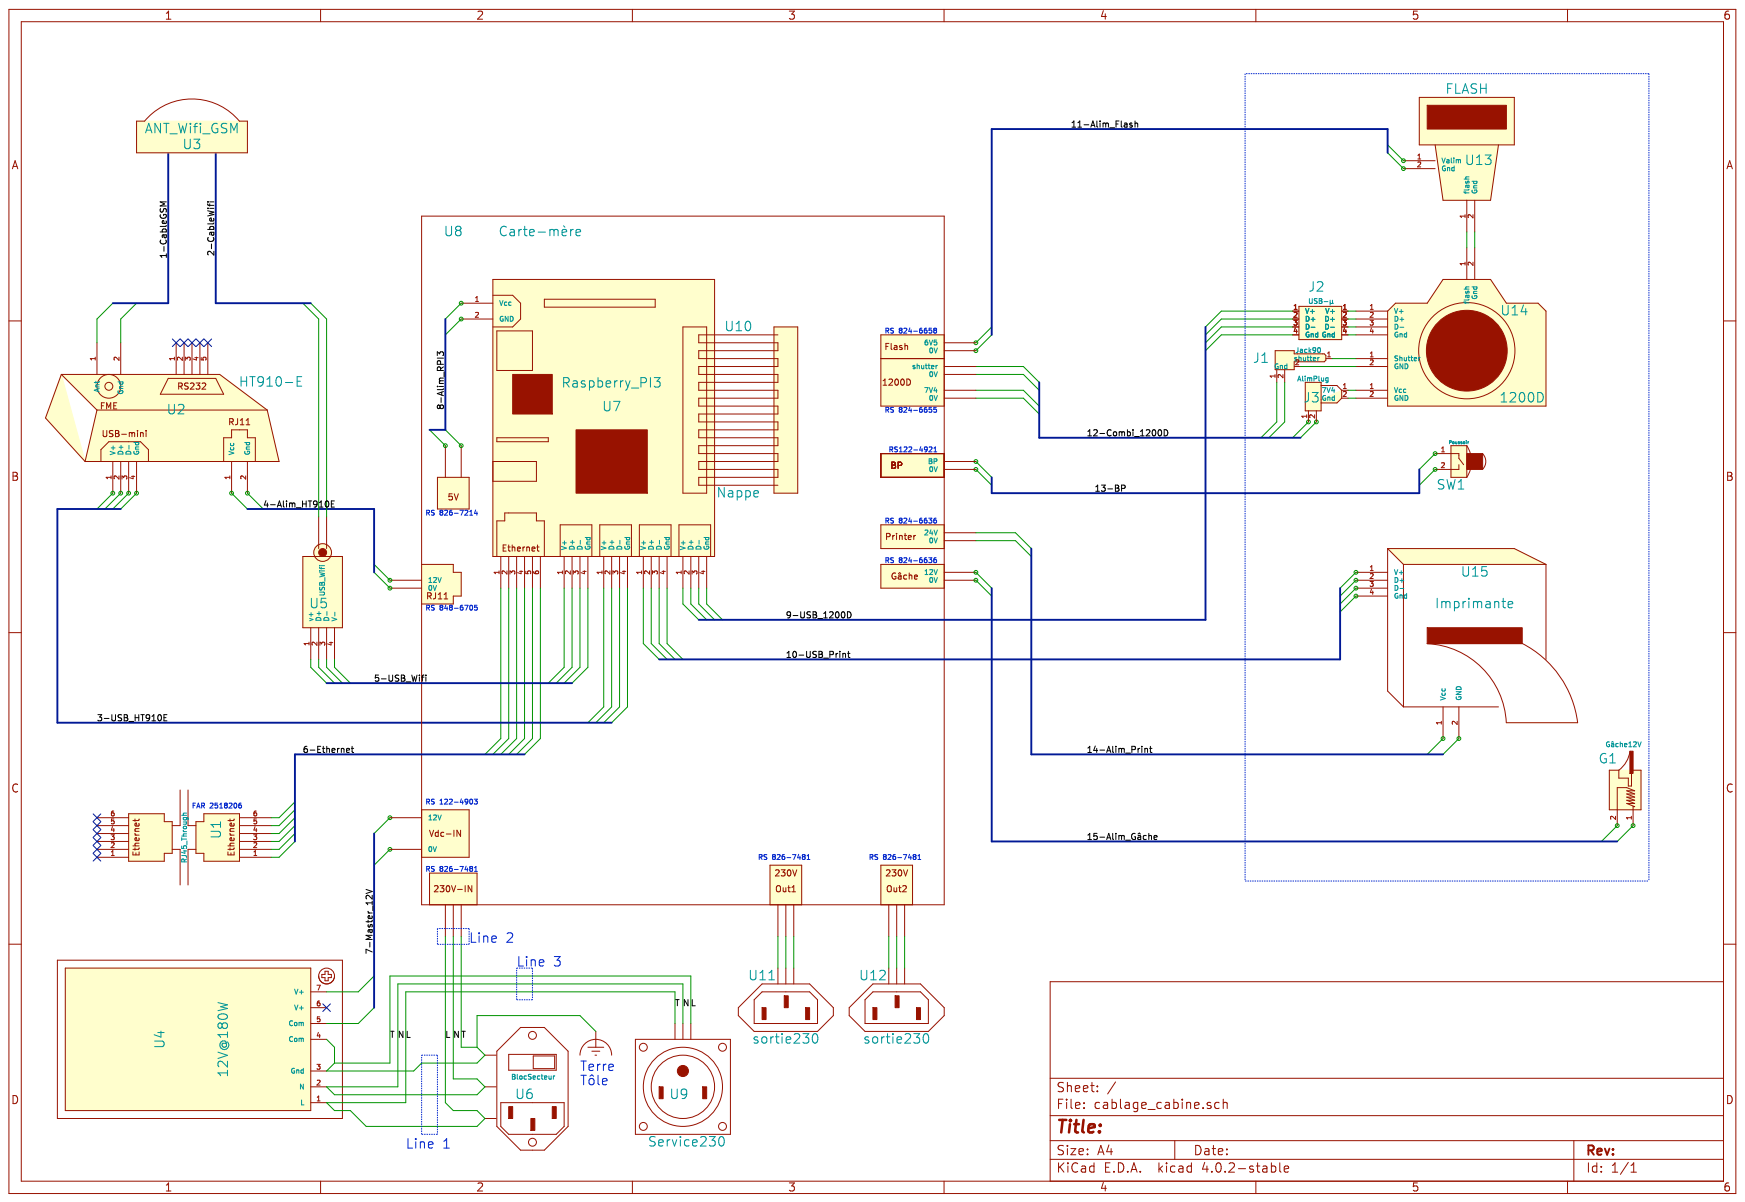
[picture p11: page 1]
