Postcard/figure-electronics/wiring/kicad/Cablage_cabine_V2.pdf

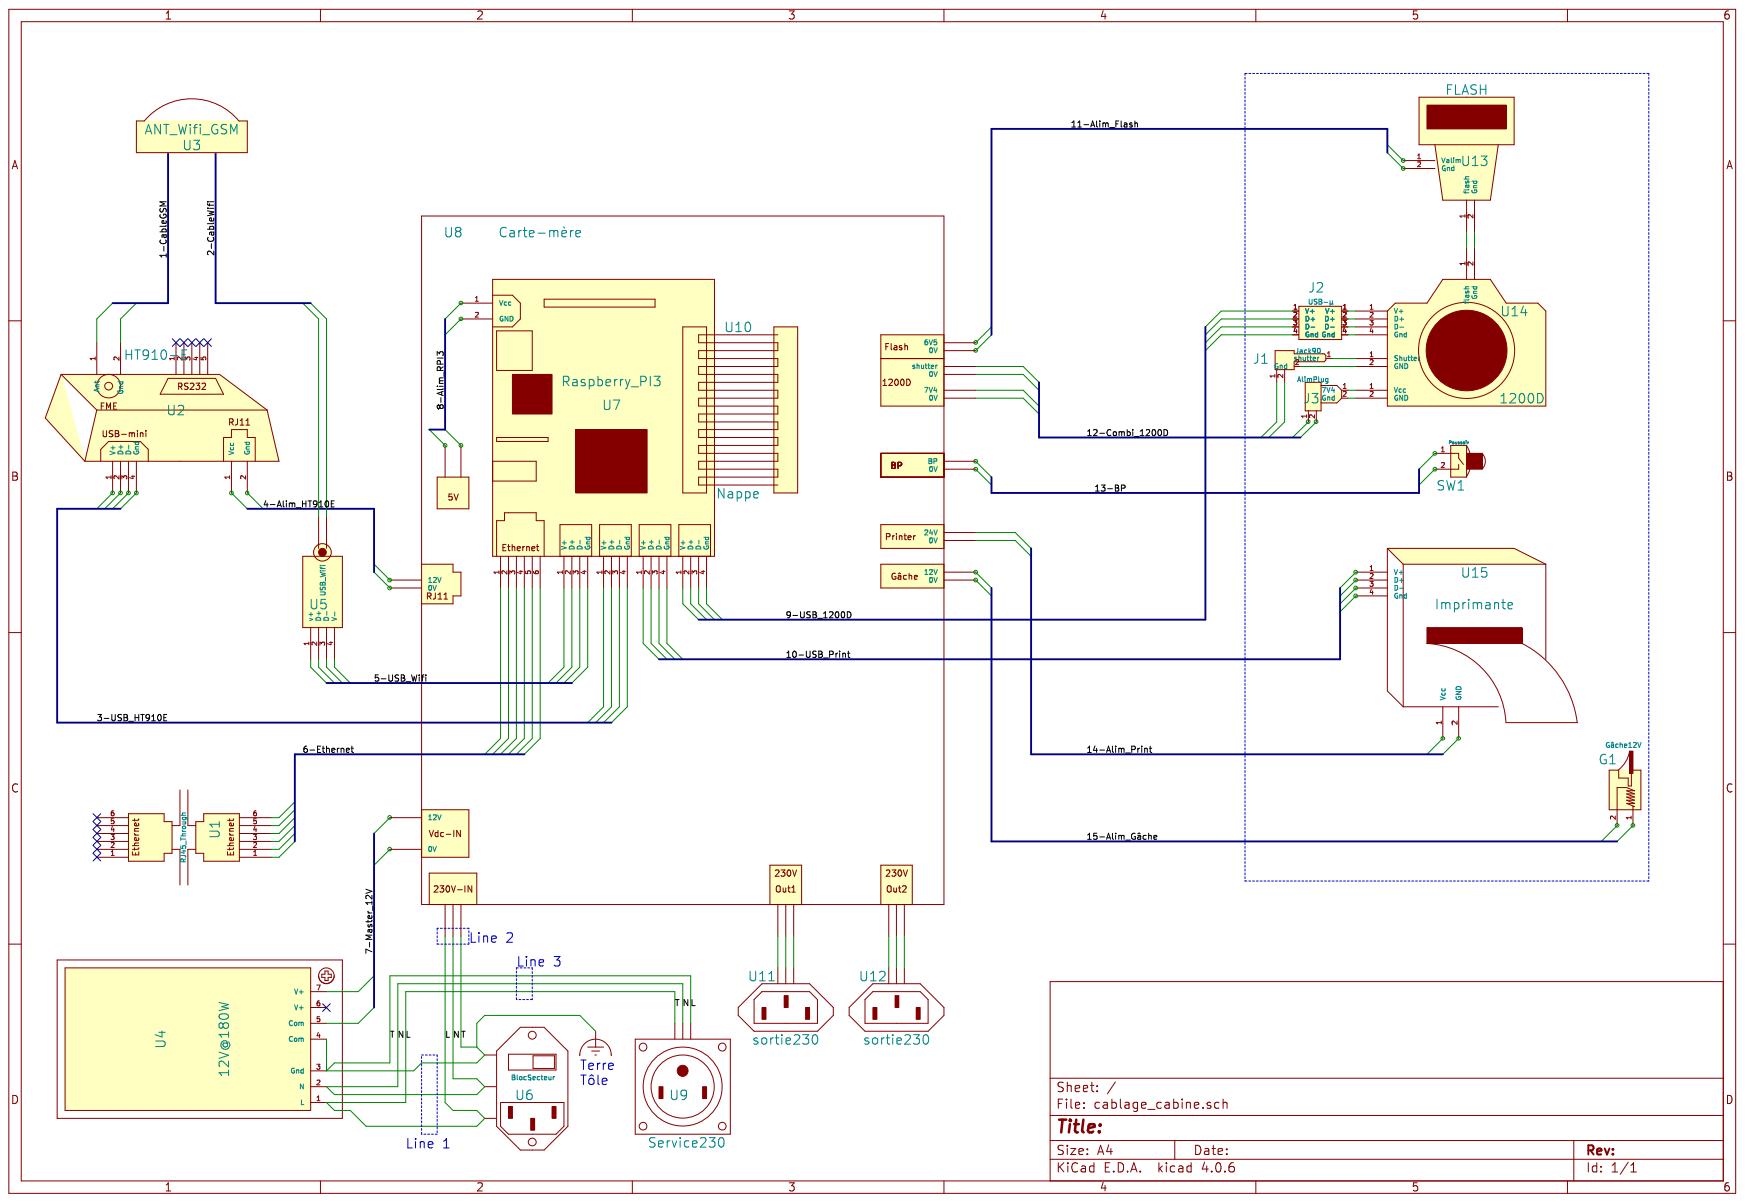
[picture p12: page 1]
