Postcard/figure-electronics/wiring/kicad/cablage_cabine.sch

## KiCad design wiring/kicad/cablage_cabine.sch (2017-04-20)

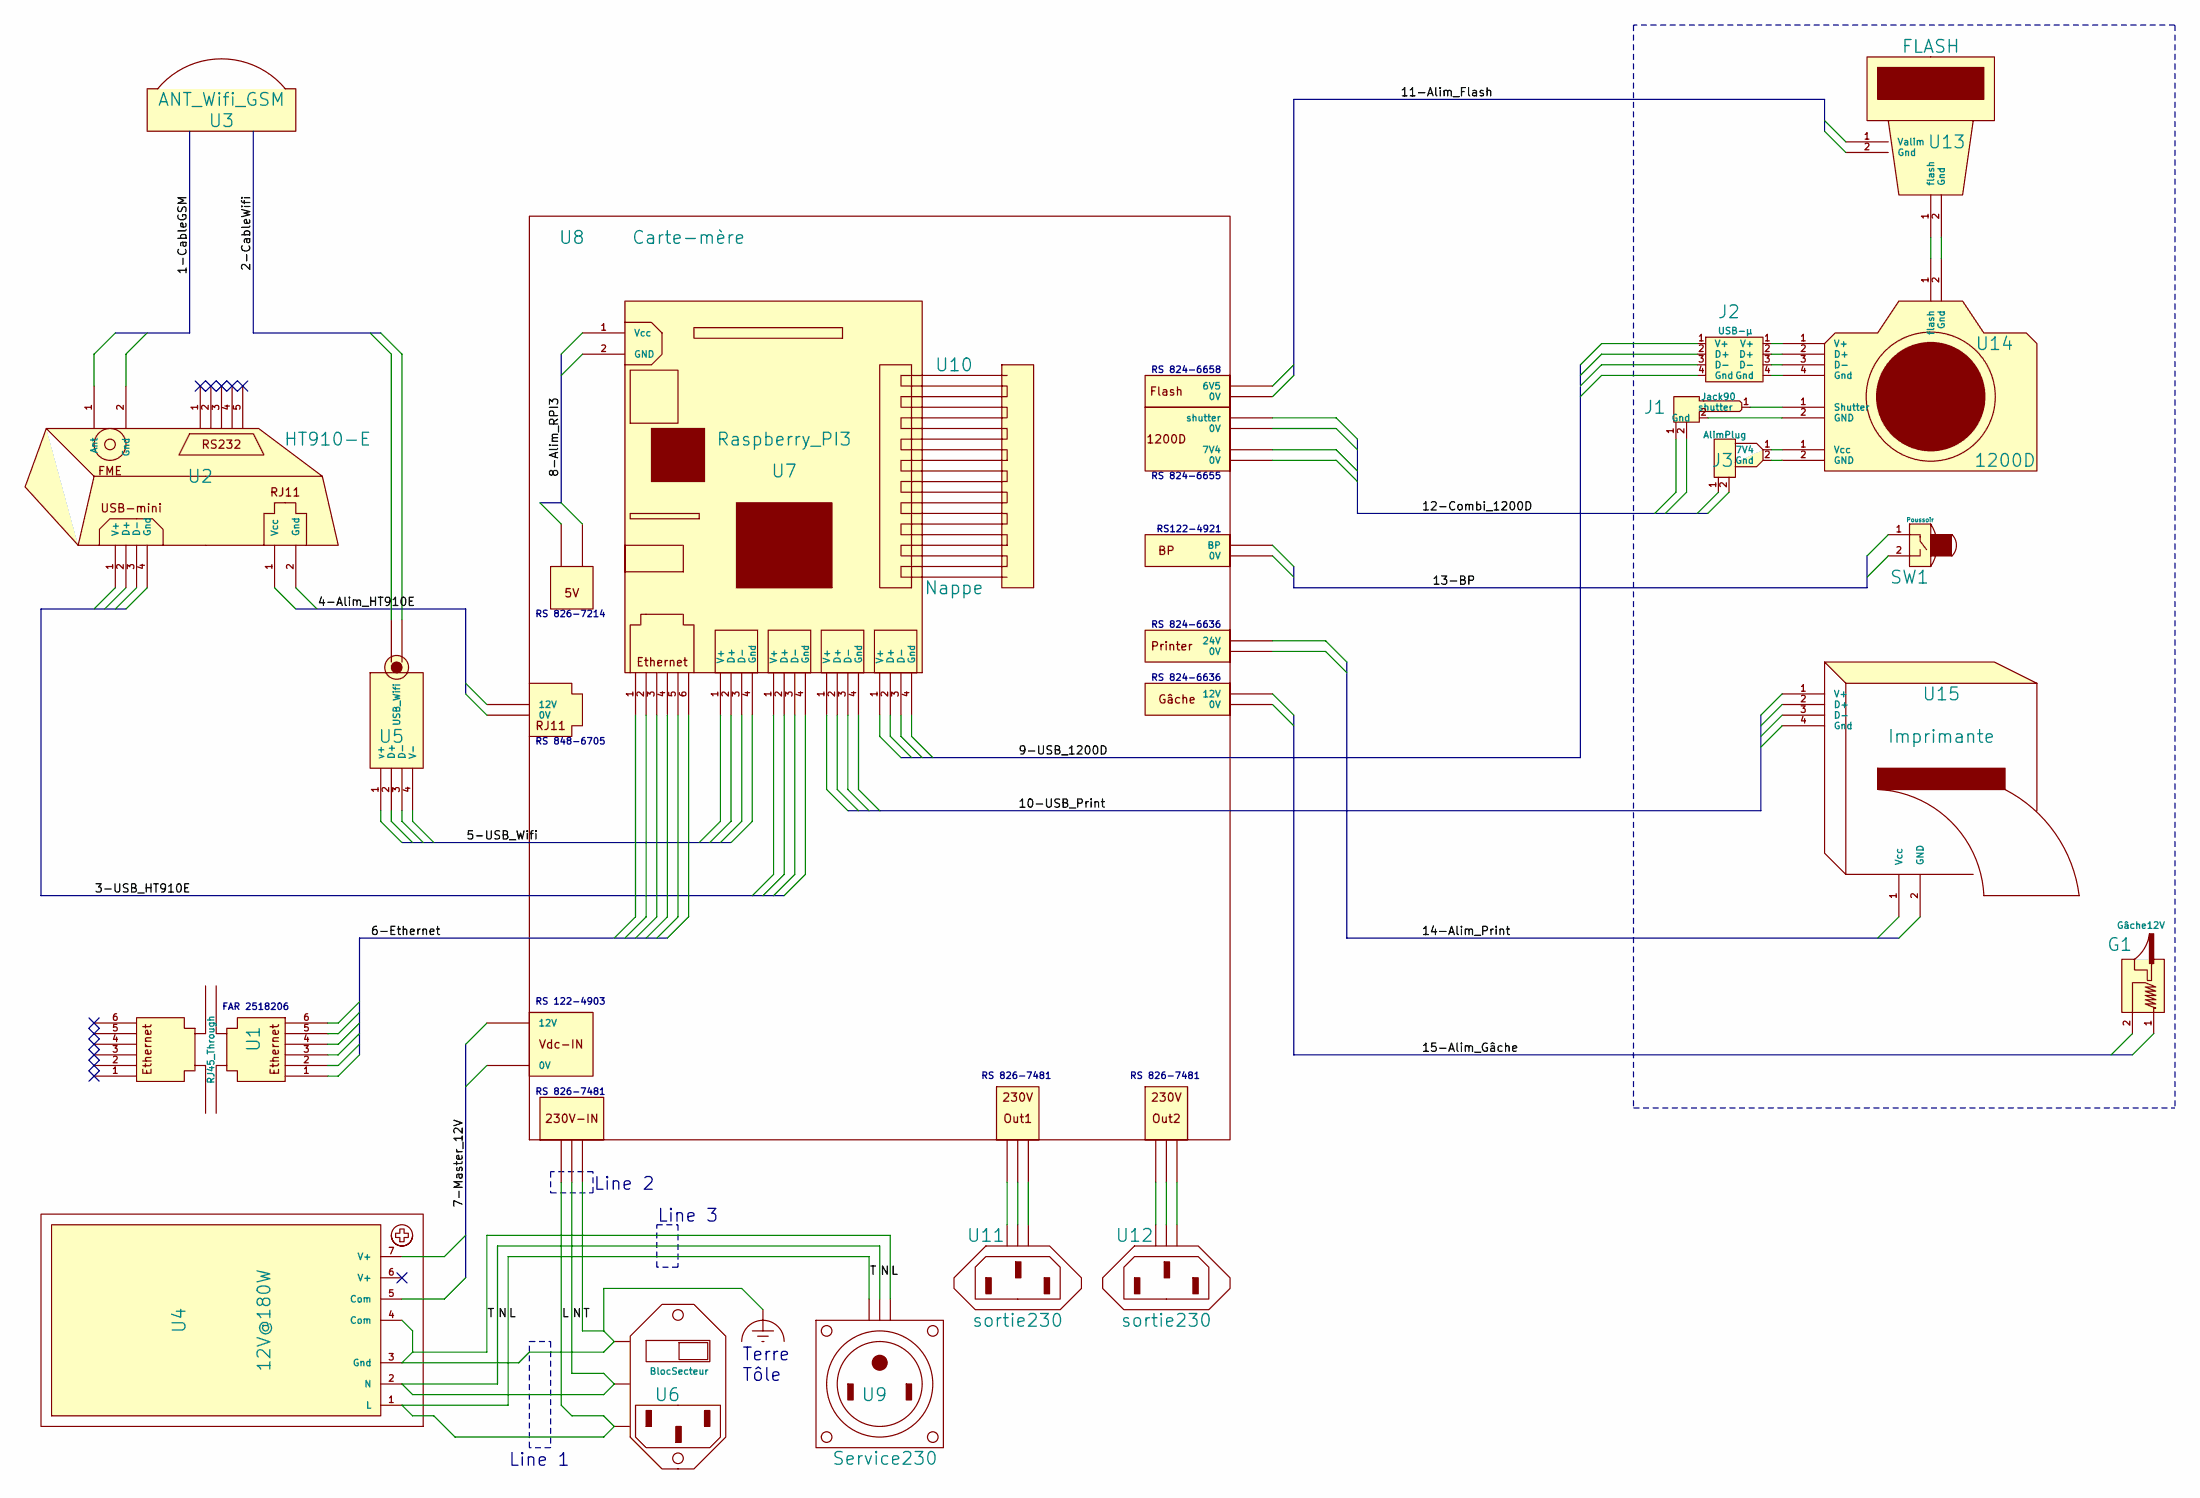
[picture p13: schematic cablage_cabine.sch]

Parts:
G1: Gâche12V
J1: Jack90
J2: USB-µ
J3: AlimPlug
SW1: Poussoir
U1: RJ45_Through
U2: HT910-E
U3: ANT_Wifi_GSM
U4: 12V@180W
U5: USB_Wifi
U6: BlocSecteur
U7: Raspberry_PI3
U8: Carte-mère
U9: Service230
U10: Nappe
U11, U12: sortie230
U13: FLASH
U14: 1200D
U15: Imprimante

Connections:
Earth_Clean: U4.1 (L), U4.3 (Gnd), U4.4 (Com), U6.~, U8.~, U9.~
N: U4.2 (N), U6.~, U8.~, U9.~
unnamed: J1.1 (shutter), U14.1 (flash)
unnamed: J1.2 (Gnd), U14.2 (D+)
unnamed: J2.1 (V+), U14.1 (flash)
unnamed: J2.2 (D+), U14.2 (D+)
unnamed: J2.3 (D-), U14.3 (D-)
unnamed: J2.4 (Gnd), U14.4 (Gnd)
unnamed: J3.1 (7V4), U14.1 (flash)
unnamed: J3.2 (Gnd), U14.2 (D+)
unnamed: U8.~, U11.~
unnamed: U8.~, U12.~
unnamed: U13.1 (flash), U14.1 (flash)
unnamed: U13.2 (Gnd), U14.2 (D+)

Notes on the sheet:
Line 1
Line 2
Line 3
Terre Tôle
RS 826-7214
RS 848-6705
RS 122-4903
RS 826-7481
RS 824-6636
RS122-4921
RS 824-6655
RS 824-6658
FAR 2518206
