Postcard/figure-electronics/(commit log)

2017-04-12 * Modification du plan de câblage. Définition des bretelles pour la partie secteur.
    [Plan cablage bretelles.ods, Plan cablage bretelles.xls, Plan cablage bretelles_V2.ods, Plan cablage bretelles_V2.xls, cablage_cabine.sch]
2017-04-20 carte mère V2 et câblage V3
    [230Detect.sch, 7V4-2A.sch, 7V5-2A.sch, Alim16V-05A.sch, Alim24V-2A5.sch, Alim24V2-5A.sch, Alim5V-2A5.sch, Alim5V2-5A.sch]
2017-04-21 add cablage bretelles V3.1
    [Plan cablage bretelles_V3.1.xls]
2017-04-24 add Plan cablage bretelles_V3.2.xls
    [Plan cablage bretelles_V3.2.xls]
2017-04-28 add length of cables
    [Plan cablage bretelles_V3.3.xls]
2017-05-19 Plan cablage brettelles_V3.4.xls
    [Plan cablage bretelles_V3.4.xls]
2017-05-19 ajout du câblage des points
2017-05-19 add lenght for a cable
    [Plan cablage bretelles_V3.4.xls]
